BlockWorker/USBPD-Supply/LLCTrace.png

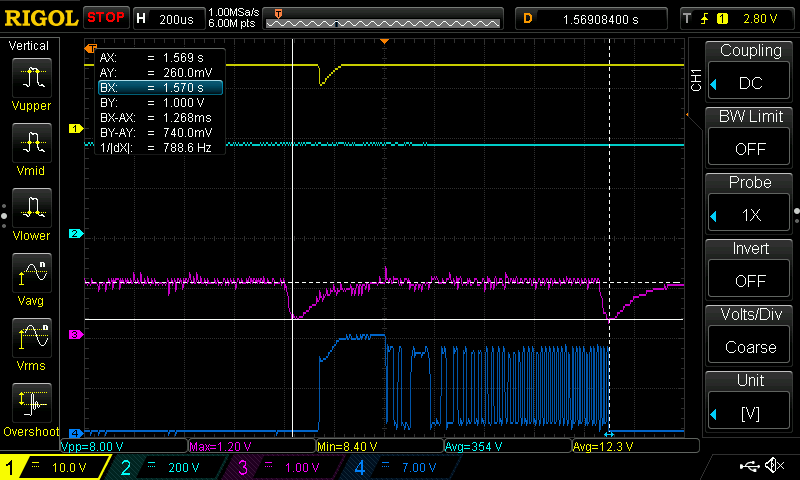
LLCTrace.png
