BlockWorker/USBPD-Supply/SchematicLLC.png

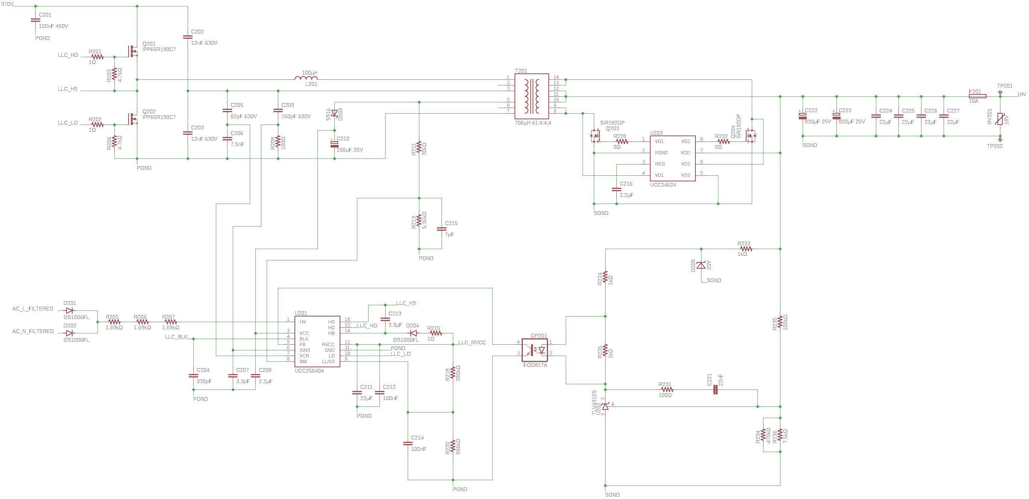
SchematicLLC.png
