BlockWorker/USBPD-Supply/SchematicPFC.png

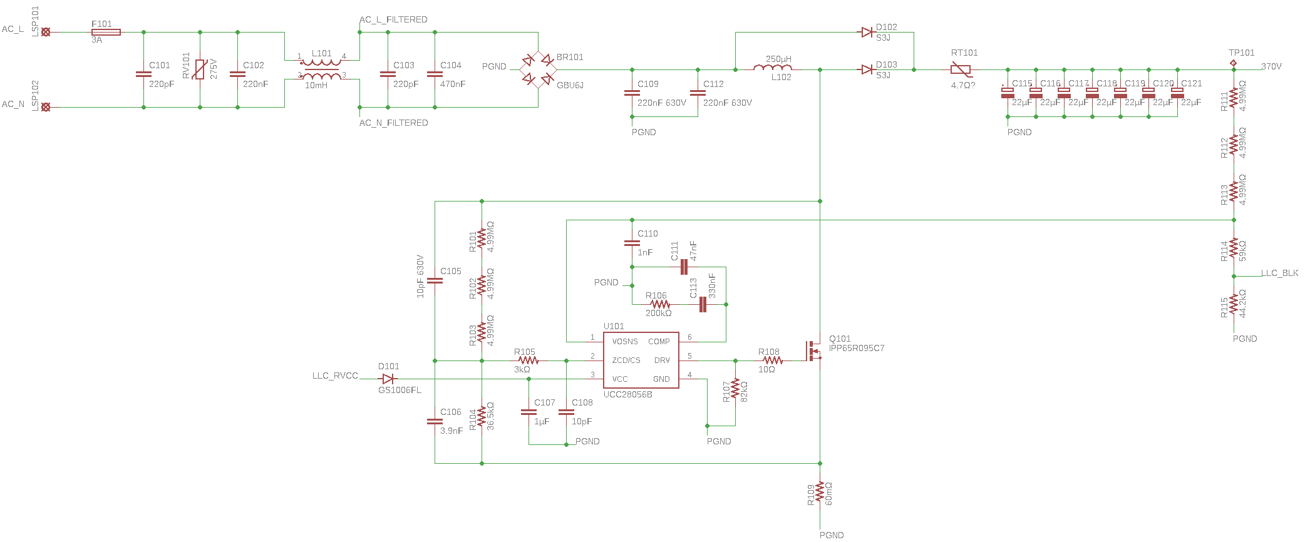
SchematicPFC.png
