BlockWorker/USBPD-Supply/TransistorFail_Event.png

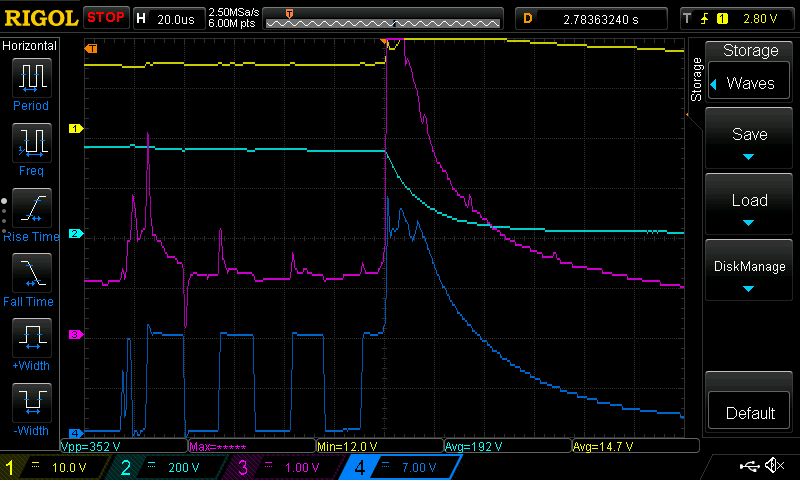
TransistorFail_Event.png
