BlockWorker/USBPD-Supply/TransistorFail_Full.png

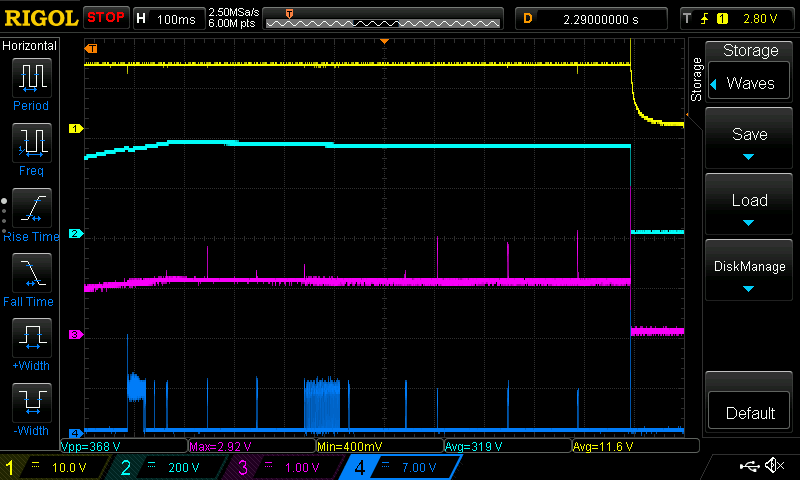
TransistorFail_Full.png
