BlockWorker/USBPD-Supply/UCC25640x Design Calculator Rev4.0.xlsx

Sheet: SCHEMATIC
RefDes | Value | Unit
RBLKupper | 14.97 | MΩ
RBLKlower | 44.2 | kΩ
RBWupper | 30.00 | KΩ
RBWlower | 5.36 | KΩ
CISNS | 150 | pF
RISNS | 100 | Ω
CVCRupper | 82 | pF
CVCRlower | 7500 | pF
Lr | 108.81 | uH
Lm | 706 | uH
Cr | 0.024 | uF
CSS | 1000 | nF
RLLupper | 390.00 | KΩ
RLLlower | 866.00 | KΩ

Sheet: Transformer Models
Power stage Gain Calcuation for discrete Lr
Power Stage Gain Calculation for Integrated Leakge

Sheet: DESIGN INPUTS AND CALCULATIONS
UCC25640x DESIGN CALCULATOR TOOL
TI Literature Number: | Version: Original
UCC25640x Enhanced LLC Resonant Controller
Please enter design parameters into the | shaded | cells;
Recommended Component Values will be in RED
Be sure to ENABLE EDITING before attempting to use this design calculator
This spreadsheet guides the user through the design process of an LLC resonant DC/DC CONVERTER using the UCC25640x. User interaction is required in order to get the best possible results. Enter the desired specification where prompted, the highlighted cells are for user inputs; calculations for the design are based upon the inputs.
WHERE APPLICABLE, A RECOMMENDED VALUE IS GIVEN THAT WILL BE THE BEST CHOICE TO MEET THE GIVEN SPECIFICATION. IT IS IN THE BEST INTEREST OF THE USER TO USE A VALUE AS CLOSE AS POSSIBLE TO THE SUGGESTED RECOMMENDED VALUE. FOR ACCURATE RESULTS, THE USER MUST ENTER THE ACTUAL VALUE USED IN THE APPROPRIATE CELL.
Disclaimer
This product is designed as an aid for customers of Texas Instruments. No warranties, either expressed or implied, with respect to this software or its fitness for any particular purpose, are claimed by Texas Instruments or the author. The software is licensed solely on an "as is" basis. The entire risk as to its quality and performance is with the customer.
Select Which Device You Are Using |  | UCC256404 |  | Refer datasheet for the difference of UCC25640x devices
OUTPUT
Output Voltage | VOUT | 18 | V | Enter required nominal output voltage of converter
Maximum Output Power | POUT | 144 | W | Enter required maximum converter output power in Watts
Full Load Output Current | IOUT | 8 | A
Maximum Output Voltage Ripple | VOUT(pk-pk) | 120 | mV | Enter the desired maximum output voltage ripple
Target Efficiency | h | 0.98 |  | Enter the Overall Efficiency here
INPUT
Nominal Input Voltage | VBLK | 370 | V | Enter the nominal input voltage
Maximum DC Input Voltage | VBLK(max) | 400 | V | Enter the maximum input voltage
Minimum DC Input Voltage | VBLK(hu) | 340 | V | Enter the minimum input voltage
LLC STAGE
Nominal LLC Switching Frequency | fLLC | 100 | kHz | Enter desired nominal LLC switching frequency
LLC Transformer
Recommended Primary/Secondary Turns Ratio | NPS(recommended) | 10.27777778
Actual Primary/Secondary Turns Ratio | NPS | 10.25 |  | Enter Actual Primary/Secondary Turns Ratio
Recommended Primary/Bias Turns Ratio | NPB(recommended) | 12.33
Actual Primary/Bias Turns Ratio | NPB | 10.25 |  | Enter Actual Primary/Bias Turns Ratio
LLC Effective Load Resistance at 110% Full Load | RE | 174.2 | Ω
LLC Effective Load Resistance at Full Load | RE(full load) | 191.6 | Ω
LLC Gain Range
Minimum LLC Gain | MG(min) | 0.948
Maximum LLC Gain Including Losses | MG(max) | 1.115
Predicted Voltage Drop Due to Losses | VLOSS | 0.000 | V | Enter the predicted voltage drop due to conversion losses in circuit
Select LN and QE
From the figure on the right, MG(peak) Vs QE with respect to LN, select a point on an Ln curve that has an Ln and QE point that corresponds to an Attainable MG(PEAK) value that is greater than MG(max). Enter the selected values in the LN and QE cells below.
For example, if MG(max), calculated above and shown by the horizontal line, was calculated to be 1.4, then using Ln = 5 and QE = 0.35 would result in an attainable MG(PEAK) = 1.52 (interpolated from Ln = 5 curve) which satisfies the requirement that the Attainable MG(PEAK) > MG(max)
Selected Primary Inductance Ratio | LN(selected) | 6.49
Selected Quality Factor for Resonant Network | QE(selected) | 0.35
Gain Required at No-Load | MG(noload) | 0.866
fN at Maximum Switching Frequency | fN(max) | 3.50
The selected LN and QE values should result in an LLC Gain Curve, shown below, that intersects with the MG(min) and MG(max) traces. The Gain curve from an overload condition is also plotted, showing the minimum gain at maximum frequency.
Parameters of the LLC Resonant Circuit
Discrete resonant inductor or transformer leakage inductance used for LR? |  | Discrete Inductor
 |  | 0.9 |  | Ignore this row
Recommended Resonant Capacitor Value | CR(recommended) | 0.024 | uF
Actual Total Value of Resonant Capacitor Used | CR | 0.024 | uF | Enter actual value of Resonant Capacitor used
Recommended Resonant Inductor Value | LR(recommended) | 105.543 | uH
Actual Resonant Inductor Value Used | LR | 108.81 | uH | Enter the actual value of the Resonant Inductor Value used
Recommended Transformer Magnetizing Inductance | LM(recommended) | 706.1769 | uH
Actual Transformer Magnetizing Inductance Used | LM | 706 | uH | Enter the actual value of the magnetizing inductance value used
Resultant Series Resonant Frequency | f0 | 98.5 | kHz
No Load Resonant Frequency | fP | 36.0 | kHz
Resultant Inductance Ratio | LN | 6.49 |  | Re-enter this value in the LN(selected) cell above to see the actual normalized frequency at MG(max) and MG(min)
Resultant Quality Factor at Full Load | QE | 0.35 |  | Re-enter this value in the QE(selected) cell above to see the actual normalized frequency at MG(max) and MG(min)
Gain Curve Graph Up to Date? |  | Yes
fN at MG(max) | fN(Mg_max) | 0.75 |  | Enter fN value at the second intersection of the MG(max) line and LLC Gain Curve shown in figure above
fN at MG(min) | fN(Mg_min) | 1.2 |  | Enter fN value at the second intersection of the MG(min) line and LLC Gain Curve shown in figure above
Maximum Switching Frequency | fSW(max) | 118.2 | kHz
Minimum Switching Frequency | fSW(min) | 73.9 | kHz
LLC Primary Side Currents
Primary Side RMS Load Current | IOE | 0.954 | A
RMS Magnetizing Current at fSW(min) | IM | 0.507 | A
Total Current in Resonant Circuit | IR | 1.080 | A
LLC Secondary Side Currents
Secondary RMS Current | IOE(S) | 9.774 | A
Current in Each Center Tapped Winding | IWS | 6.912 | A
LLC Resonant Inductor
Terminal AC Voltage Across Resonant Inductor | VLr | 54.538 | V
Inductance | LR | 108.810 | uH
Rated Current | IR | 1.080 | A
LLC Resonant Capacitor
AC Voltage Across Resonant Capacitor | VCR | 97.0 | V
RMS Voltage Across Resonant Capacitor | VCR(rms) | 222.3 | V
Peak Voltage AC Voltage Rating for Resonant Capacitor | VCR(peak) | 337.1 | V
Valley Voltage on Resonant Capacitor | VCr(valley) | 62.9 | V
Rated Current of Resonant Capacitor | IR | 1.080 | A
If Using Split Resonant Capacitors
Value of EACH Resonant Capacitor If Using Split Resonant Capacitors | CR(split) | 0.012 | uF
LLC Primary Side MOSFETs
Minimum Voltage Rating of LLC MOSFETs | VQLLC(peak) | 600.0 | V
RMS Current Rating of LLC MOSFETs | IQLLC | 1.188 | A
LLC Output Rectifier Diodes/Synchronous rectifiers
Minimum Voltage Rating for LLC Output Diodes | VDB | 46.829 | V
Minimum Current Rating for LLC Output Diodes | ISAV | 4.400 | A
LLC Output Capacitors, COUT
Rectifier's full wave output current | IRECT | 8.886 | A
COUT Minimum Voltage Rating | VLLCcap | 20 | V
COUT RMS Ripple Current Rating at resonant frequency | IC(out) | 3.867 | A | Use a combination of Capacitors that will meet this ripple current rating
COUT Maximum ESR | ESRmax | 9.549 | mΩ
BLK
BLK Pin Start Threshold | VBLKpinstart | 1.00 | V
BLK Pin Stop Threshold | VBLKpinstop | 0.90 | V
Desired Bulk Start Voltage | VBLKStart | 340 | V
Nominal Bulk Voltage | VBLK | 370 | V
Resistor Divider Ratio | kBLK | 340
Resistor Divider Power Consumption Budget | PBLKsns | 10 | mW | Enter the desired power consumption for resistor divider
Total BLK Sense Resistor Value | RBLKsns | 13.69 | MΩ
Recommended Lower BLK Sense Resistor Value | RBLKlower | 40.26 | kΩ
Actual Lower BLK Sense Resistor Value | RBLKlower | 44.2 | kΩ | Enter the actual value of the lower BLK sense resistor used
Recommended Upper BLK Sense Resistor Value | RBLKupper | 13.65 | MΩ
Actual Upper BLK Sense Resistor Value | RBLKupper | 14.97 | MΩ | Enter the actual value of the upper BLK sense resistor used
Actual Bulk Start Voltage | VBLKStart | 339.6877828 | V
Actual Bulk Stop Voltage | VBLKstop | 305.7190045 | V
Actual Bulk Over-Voltage Threshold Rising Threshold | VBLKOVPrise | Not Applicable | V | BLK OVP Feature only present in UCC256402A
Actual Bulk Over-Voltage Threshold Falling Threshold | VBLKOVfall | Not Applicable | V | BLK OVP Feature only present in UCC256402A
Actual BLK divider power consumption | PBLKsns | 9.118 | mW
VCR
Peak Resonant Current at Full Load | Ires(peak) | 1.53 | A
Peak to Peak Resonant Capacitor Voltage at Full Load | VCR(pk-pk) | 274.237 | V
Common Mode Voltage of VCR Pin | VCM | 3.02 | V
Set VCR pin voltage peak to peak at full load, minimum switching frequency | VVCRpin(pk-pk) | 5.25 | V | Suggested range between 3V and 5.5V
Set Contribution of compensation ramp to total VCR capacitor peak to peak voltage | Vramp(pk-pk) | 2 | V | Suggested range between 1V and 2.0V
Compensation Ramp Current Source Value | IRamp | 2 | mA
Required capacitor divider ratio | kCapDiv | 84.38
Recommended Capacitor Divider Value - Lower Cap | CVCRlower | 6769.064234 | pF
Actual Capacitor Divider Value - Lower Cap | CVCRlower | 7500.0 | pF | Enter the Capacitor divider value - lower cap
Recommended Capacitor Divider Value - Upper Cap | CVCRupper | 89.94912205 | pF
Actual Capacitor Divider Value - Upper Cap | CVCRupper | 82.0 | pF | Enter the Capacitor divider value - upper cap
Actual capacitor divider ratio | kCapDiv | 92.5
Actual peak to peak VCR voltage at minimum switching frequency | VVCRpin(pk-pk) | 4.77 | V
Maximum VCR Voltage | VVCRmax | 5.41 | V
Minimum VCR Voltage | VVCRmin | 0.63 | V
BW
Desired OVP Threshold Percentage of Nominal Vout | ƞOVP | 140 | % | Enter the OVP threshold (percentage)
OVP Threshold Adjustment to Account for Rectifying Element, Transformer Leakage, Resistive Losses In Power Stage, etc. | VDrop | 1 | V | Enter estimation for voltage drop within power stage (rectifying element, resistive losses, transformer leakage, etc).
OVP Threshold | VBWOVP | -4 | V
BW Pin Voltage at Nominal Vout | VBWpinNom | -2.86 | V
Bias Winding Nominal Voltage | VBiasWindingNom | 19.0 | V
Bias Winding Resistor Divider Ratio | kBW | 6.650
Select Option for Burst Mode Threshold Entry to Burst Mode Threshold Exit Ratio | kBMT | Option 6 |  | Select Ratio between burst mode entry and burst exit, Note Option 5 forces Vssinit to be 0 V while option 6 allows programming an initial Vssinit voltage value
Ratio Between Burst Mode Entry and Burst Mode Exit | kBMT | 0.6
Recommended Effective BW Programming Resistance | RBMTProgram | 4.591 | KΩ
Recommended Bias Winding Lower Resistor Value | RBWlower | 5.404 | KΩ
Actual Bias Winding Lower Resistor Value | RBWlower | 5.360 | KΩ | Enter Bias winding lower resistor value
Recommended Bias Winding Upper Resistor Value | RBWupper | 30.284 | KΩ
Actual Bias Winding Upper Resistor Value | RBWupper | 30.000 | KΩ | Enter Bias winding upper resistor value
Actual BW Programming Resistance | RBMTProgram | 4.548 | KΩ
Actual Option for Ratio Between Burst Mode Entry and Burst Mode Exit | kBMT | Option 6
Actual Ratio Between Burst Mode Entry and Burst Mode Exit | kBMT | 0.60
Actual OVP Threshold Percentage of Nominal Vout | ƞOVP | 138.9 | %
BW Filter Capacitor Needed so That the Bandwidth is 50 Times the Resonant Frequency |  | 7.11 | pF
Actual BW Filter Capacitor |  | 7.00 | pF | Enter the actual BW filter capacitor value
LL/SS
SS Current Source Value | ISSUp | 37.5 | µA
Required Soft Start Time at Full Load | TSS | 15 | ms | Enter the required soft start time at full load
Recommended SS Capacitance Value | CSS | 111.2489721 | nF
Actual SS Capacitance Value | CSS | 1000 | nF | Enter the selected soft start capacitance
Target Burst Mode Threshold Exit Setting | VBMT_H | 2.00 | V | Enter the desired burst mode threshold.
Minimum Soft Start Precharge Voltage Based on VBMT_H and Css | Vssinit_min | 0.055 | V
Desired initial Soft Start Precharge Voltage | Vssinit | 0.07 | V | Enter the desired initial soft start voltage. Note Vssinit must satisfy the inequality above unless BW Option 5 is selected. This calculation is provded in Cell 202. It is recommended to limit the precharge voltage to less than 1V.
Recommended Upper LL/SS Resistance | RLL/SS_Upper | 383.4 | kΩ
Recommended Lower LL/SS Resistance | RLL/SS_Lower | 800.9 | kΩ
Actual Upper LL/SS Resistance | RLL/SS_Upper | 390.0 | kΩ | Enter the LL/SS divider value upper resistance
Actual Lower LL/SS Resistance | RLL/SS_Lower | 866.0 | kΩ | Enter the LL/SS divider value lower resistance
Actual initial Soft Start Precharge Voltage | Vssinit | 0.066 | V
Maximum attainable LL/SS Voltage at End of Soft Start | Vssinit_final | 19.047 | V | Recommended to have >5V for max attainable LL/SS voltage
Actual Burst Mode Exit Threshold | VBMT_H | 2.032 | V
Actual Burst Mode Entry Threshold | VBMT_L | 1.219 | V
Burst Packet Size | NBurst | 40 |  | Minimum number of switching cycles in each burst packet
Actual Soft Start Time at Full Load | TSS | 125.5 | ms
ISNS
OCP3 Threshold |  | 0.43 | V
OCP2 Threshold |  | 0.6 | V
OCP1 Threshold |  | 4 | V
Desired OCP3 Threshold (Percentage of Full Load at Nominal Input Voltage) |  | 130 | % | Enter the desired OCP threshold (percentage)
Calculated OCP2 Level (Percentage of Full Load at Nominal Input Voltage) |  | 181.4 | %
Sensed Average Input Current Level at Full Load |  | 0.33 | V
Current Sense Ratio | kISNS | 0.83
Select a Current Sense Capacitor | CISNS | 150 | pF | Enter the current sense capacitor value such that the calculated RISNS < 500 Ω
Recommended Current Sense Resistor | RISNS | 133.2632479 | Ω
Actual Current Sense Resistor | RISNS | 100 | Ω | Enter the actual current sense resistor value
Peak VISNS at Full Load |  | 0.95 | V
Ires peak at OCP1 Level |  | 6.40 | A
Isec peak at OCP1 Level |  | 65.60 | A

Sheet: Comepsation and Transient
 | UCC25640X LLC Loop Plot & Load Transient Validation & Tuning Tool
LLC Power Stage Input |  |  |  | LLC Controller Parameter Setting |  |  |  | UCC25640X Loop Circuit setting
PFC input | Vin | 370 | VDC | VCR divider Capacitor_Higher Cap | CdivH | 82 | pF | Equivalent Controller Internal Resistor | RFB | 50 | kΩ
Output Rectifier forward Voltage | Vf | 0 | VDC | VCR divider Capacitor_Lower Cap | CdivL | 7.5 | nF | Feedback Pull up Resistor | Rf | 2 | kΩ
Set output Voltage | Vo_set | 18 | VDC | Calculated Parralled value | Cdivp | 81.11316275 | pF | OPTO Current Transfer Ratio | CTR | 0.8
Output Load current under R Load | Io | 8 | A | Calcualted Series Value | Cdivs | 7.582 | nF | OPTO Rolling off Frequency | f_roll | 15 | kHz
output total Capacitor Value | Co | 1640 | uF | Calcualted divided Value | λ | 0.01081508837 |  | Resistor for f_roll compensation | Rz | 1000 | Ω
Equivalent ESR for Co | Rc | 20 | mΩ | MOS Junction Capacitor | Cj | 0.374 | nF | Calculate Cz for f_roll compensation | Cz_cal | 3.183098862 | nF
LLC Transformer Magnetizing Inductance | Lm | 706 | uH | Output Load Transient Setting |  |  |  | Capacitor for f_roll compensation | Cz | 3.3 | nF
LLC Transformer Resonant Inductance | Ls | 108.81 | uH | Load step current | I_step | 7 | A | Rv compensation | Rv | 0.1 | kΩ
LLC Resonant Capacitor | Cr | 24 | nF | Load current step Duty cycle | Dstep | 0.5 |  | Cv compensation | Cv | 22 | nF
Equivalent Transformer Turn Ratio(Np:Ns) | N | 10.25 |  | Load step Frequency | fload | 0.2 | KHz | Cf compensation | Cf | 100 | pF
Actual Operation Frequency(Measured) | Fs | 100 | kHz | Load step slew rate | kslew | 20 | A/us | High side feedack resistor | Rupper | 100 | kΩ
Output R_Load | Rload | 2.25 | Ω | Load step Rising time | tr | 3.5e-07 | s | Feedack Circuit Design Option
Eqivalent LLC output | Vo | 18 | VDC | Load step on time | th | 0.0025007 | s | Use capacitor Cf?("Yes" for 1 and "No" for 0) |  | α_Cf | 0
Resonant Frequency | Fo | 98.48727144 | kHz | Load step Period | tload | 0.005 | s | Use Rz and Cz?("Yes" for 1 and "No" for 0) |  | α_Rz_Cz | 0
PFC Input AC Ripple(pk-pk) | Vinac | 10 | VAC | Center Step Load current | Istep_avg | 4 | A | Connect Rf to Vout?("Yes" for 1 and "No" for 0) |  | feedtype | 1
PFC Input AC Frequency | Fline | 50 | HZ
Crossover Frequency |  | #N/A | kHz
Phase Margin |  | #N/A | °
Calculation Result

Sheet: App Notes and Reference Designs
Application Notes
How to reduce audible noise and power consumption at standby in your AC/DC design (https://e2e.ti.com/blogs_/b/powerhouse/archive/2020/04/22/how-to-reduce-audible-noise-and-power-consumption-at-standby-in-your-ac-dc-design)
Migrating to UCC25640x from UCC25630x (Rev. A) (https://www.ti.com/lit/pdf/slua966)
Improving Transient Response in LLC Converters Using Hybrid Hysteretic Control (Rev. A) (https://www.ti.com/lit/pdf/slua834)
EVMs
AC to isolated DC EVM with UCC28056B, UCC256404 and UCC24624 (https://www.ti.com/tool/PFCLLCSREVM034)
UCC25640x half bridge LLC evaluation module (https://www.ti.com/tool/UCC25640EVM-020)
Reference Designs
180-W universal input PFC + LLC TV power supply reference design (https://www.ti.com/tool/PMP40580)
93% Efficiency, 400-W AC/DC reference design for avionics (https://www.ti.com/tool/PMP30763)
336-W Auxless AC/DC power supply reference design with 80 PLUS platinum compatible performance (https://www.ti.com/tool/PMP22087)
LLC Resonant converter control card reference design (https://www.ti.com/tool/PMP22088)
Universal input, 500-W CC/CV e-Bike charger reference design (https://www.ti.com/tool/PMP40766)
Single-stage AC/DC LCC resonant converter reference design (https://www.ti.com/tool/PMP22083)
>95% Efficiency, 1-kW analog control AC/DC reference design for 5G telecom rectifier (https://www.ti.com/tool/TIDA-010081)
Simplis Simulation Model
UCC25640x Simplis Model (https://www.ti.com/lit/zip/slum684)
