BlockWorker/USBPD-Supply/UCC28056X_Design Calculator.xls

Sheet: SCHEMATIC
Typical Schematic for a CRM/DCM Boost PFC Converter Using the UCC28056
 | RECOMMENDED BILL OF MATERIALS
 | Reference Designator | Description/Comments
 | FUSE | Type: | Fast Acting
 |  | Voltage Rating: | 250 | VRMS
 |  | Current Rating: | 3.00 | A
 | DB1 | DC Blocking Voltage: | 500 | V
 |  | Current Rating: | 3.00 | A
 |  | Power Dissipation: | 2.76 | W
 | CIN | Type: | Film Capacitor
 |  | Value: | 0.22 | µF
 |  | Volatge Rating: | 255 | VRMS
 | LBST | Inductor Value: | 250.00 | µH
 |  | Peak Current Rating: | 7.24 | µH
 |  | RMS Current: | 2.96 | A
 |  | Saturated Current: | 9.17 | A
 | D1 | Type: | Diode
 |  | Current Rating: | 3.00 | A
 |  | Volatge Rating: | 500 | V
 |  | Power Dissipation: | 0.48 | W
 | Q1 | Type: | MOSFET, Nchannel
 |  | RMS Drain Current Rating: | 2.00 | A
 |  | Peak Current Rating: | 1.60 | A
 |  | Voltage Rating: | 600 | V
 |  | Power Dissipation: | 1.00 | W
 | RCS | Type: | Resistor, Low Inductance
 |  | Value: | 0.06 | W
 |  | Power Dissipation: | 0.10 | W
 | RCS_FILTER | Type: | Resistor, Chip, 1/16W
 |  | Value: | 3000 | W
 | CCS_FILTER | Type: | Capacitor, Ceramic, 100V, X7R, ±10%
 |  | Value: | 10 | pF
 | RZC1 | Type: | Resistor, Low Inductance
 |  | Value: | 14.97 | MW
 |  | Power Dissipation: | 0.10 | 0
 | RZC2 | Type: | Resistor, Low Inductance
 |  | Value: | 36.5 | kW
 |  | Power Dissipation: | 0.10 | 0
 | COUT | Type: | Capacitor, Aluminum, ±20%
 |  | Value: | 150 | µF
 |  | Voltage Rating: | 500 | V
 |  | 2 x fLINE Ripple Current Rating: | 0.306 | ARMS
 |  | HF Ripple Current Rating: | 1.088 | ARMS
 | ROS1 | Type: | Resistor, Chip, Total Voltage Rating 400V, ±1%
 |  | Value: | 9 | MW
 | ROS2 | Type: | Resistor, Chip, 1/10W, ±1%
 |  | Value: | 0 | kW
 | ROS3 | Type: | Resistor, Chip, 1/10W, ±1%
 |  | Value: | 62 | kW
 | CVOSNS | Type: | Capacitor, Ceramic, 50V, X7R, ±10%
 |  | Value: | 1000 | pF
 | CZ | Type: | Capacitor, Ceramic, 10V, X5R, ±10%
 |  | Value: | 0.33 | mF
 | RZ | Type: | Resistor, Chip, 1/10W, ±1%
 |  | Value: | 200 | kW
 | CP | Type: | Capacitor, Ceramic, 10V, X5R, ±10%
 |  | Value: | 0.047 | mF
 | CVCC | Type: | Ceramic, Low ESR/ESL, placed close to the VCC and GND pins with short traces
 |  | Values: | 0.1 | mF min
 |  |  | 1 | mF max
 | RGATE | Type: | Resistor, Chip, 1/10W, ±1%
 |  | Value: | As Needed
 | RDG | Type: | Resistor, Chip, 1/10W, ±1%
 |  | Value: | As Needed

Sheet: DESIGN INPUTS AND CALCULATIONS
UCC28056X DESIGN CALCULATOR TOOL
TI Literature Number: |  | Rev A
UCC28056X 6-Pin Single-Phase Transition-Mode PFC Controller
Please enter design parameters into the | shaded | cells;
Calculated results will be in RED |  |  |  |  | COMP | 0.1 | 0.2 | 0.25 | 0.5 | 0.75 | 1
Be sure to ENABLE EDITING before attempting to use this design calculator |  |  |  |  | VFF_F | 90 | 104.96 | 122.4 | 142.74 | 166.46 | 194.12 | 226.38 | 264 | alpha | TONn(0.1) | TONn(0.2) | TONn(0.25) | TONn(0.5) | TONn(0.75) | TONn(1) | TDCHn(0.1) | TDCHn(0.2) | TDCHn(0.25) | TDCHn(0.5) | TDCHn(0.75) | TDCHn(1) | Freq(0.1)
This spreadsheet guides the user through the design process of a Transition-Mode PFC BOOST CONVERTER using the UCC28056X. User interaction is required in order to get the best possible results. Enter the desired specification where prompted, the highlighted cells are for user inputs; calculations for the design are based upon the inputs. |  |  |  |  | TDCMCoe | 0.15 | 0.45 | 0.16 | 0.52 |  |  |  |  | 0.01 | 0.3474399432 | 0.3335539928 | 0.3246635995 | 0.3676269822 | 0.5514404733 | 0.7352539643 | 0.001327962407 | 0.001274888428 | 0.001240908144 | 0.001405119997 | 0.002107679996 | 0.002810239995 | 47403.03457 | 102864.3291 | 135719.0137 | 211702.4496 | 141134.9664 | 105851.2248
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
