BlockWorker/USBPD-Supply/Adapter sketches/back.dxf

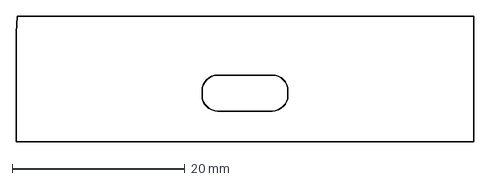
[picture p6: CAD file, 2023-05-07]
Adapter sketches/back.dxf
53.0 x 14.5 mm
