BlockWorker/USBPD-Supply/BottomCover.stl

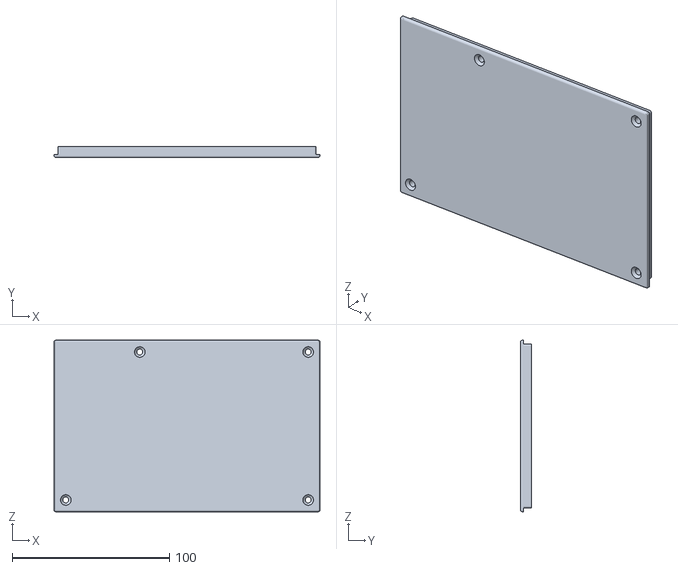
[picture p7: CAD file, 2024-01-15]
BottomCover.stl
169.0 x 7.00 x 109.0
