BlockWorker/USBPD-Supply/Adapter sketches/front.dxf

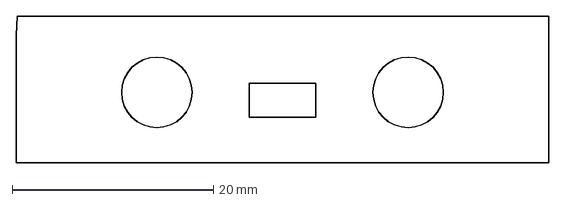
[picture p8: CAD file, 2023-05-07]
Adapter sketches/front.dxf
53.0 x 14.5 mm
