BlockWorker/USBPD-Supply/Adapter sketches/top.dxf

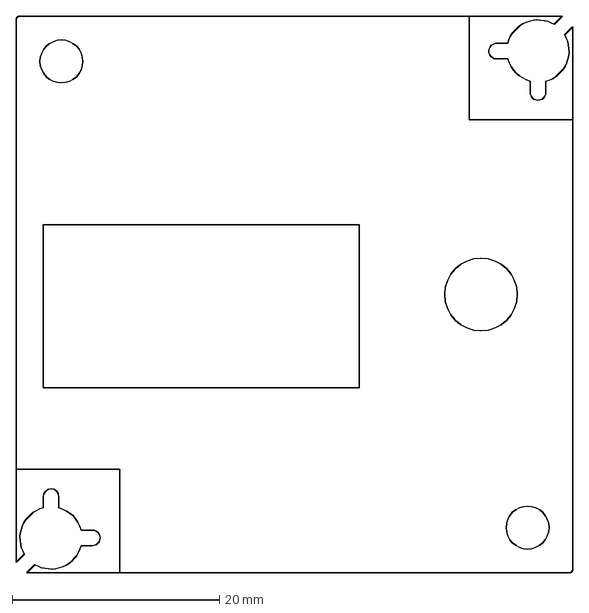
[picture p9: CAD file, 2023-05-07]
Adapter sketches/top.dxf
53.7 x 53.7 mm
