BlockWorker/USBPD-Supply/pfc/DS1Z_QuickPrint3.png

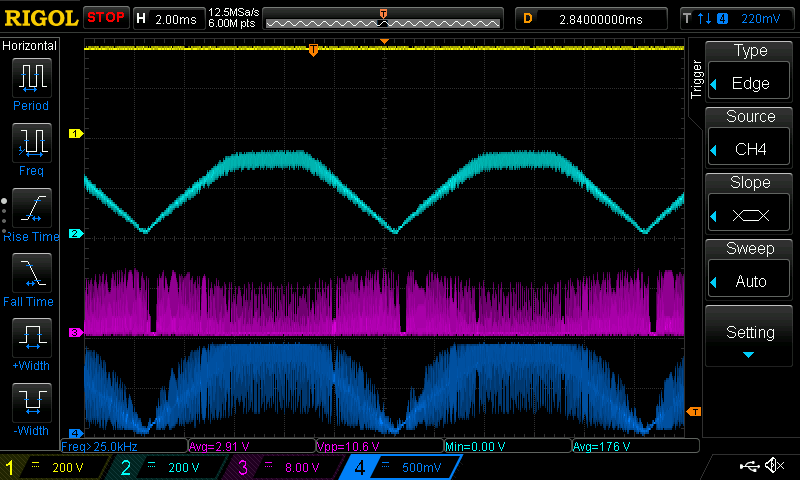
pfc/DS1Z_QuickPrint3.png
