BlockWorker/USBPD-Supply/pfc/DS1Z_QuickPrint4.png

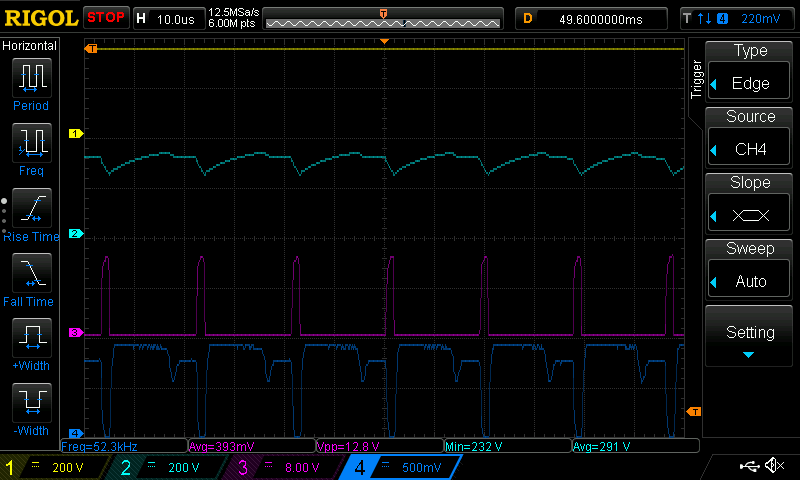
pfc/DS1Z_QuickPrint4.png
