BlockWorker/USBPD-Supply/pfc/DS1Z_QuickPrint5.png

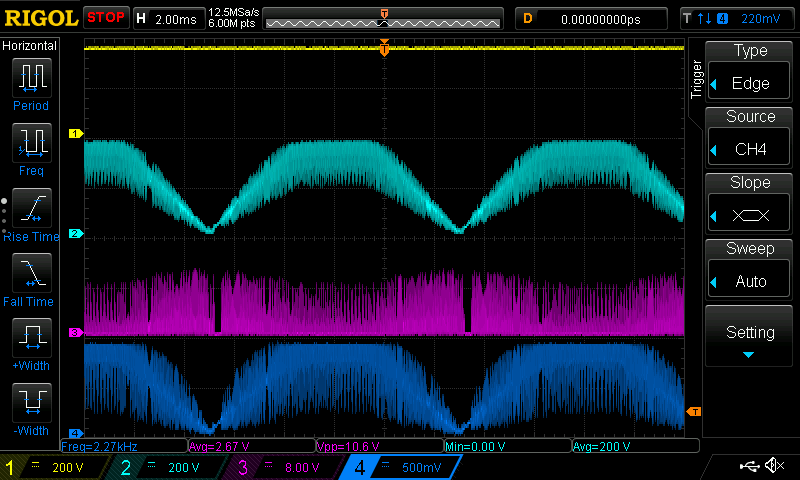
pfc/DS1Z_QuickPrint5.png
