BlockWorker/USBPD-Supply/pfc/DS1Z_QuickPrint6.png

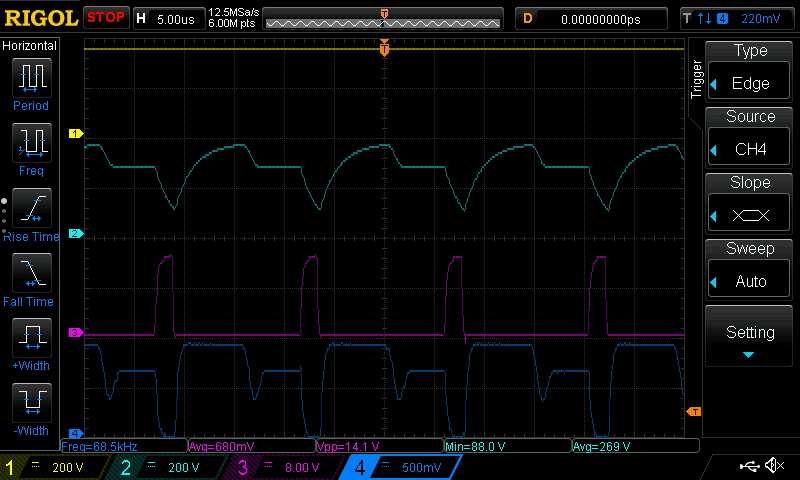
pfc/DS1Z_QuickPrint6.png
