BlockWorker/USBPD-Supply/pfc/DS1Z_QuickPrint7.png

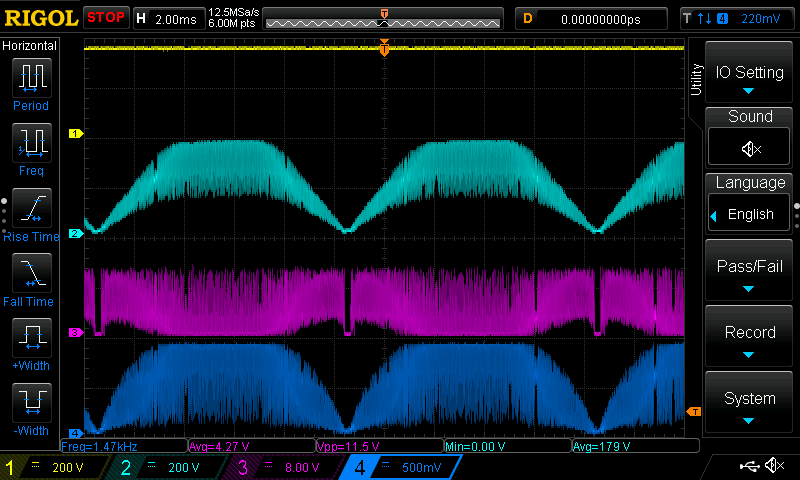
pfc/DS1Z_QuickPrint7.png
