BlockWorker/USBPD-Supply/pfc/DS1Z_QuickPrint8.png

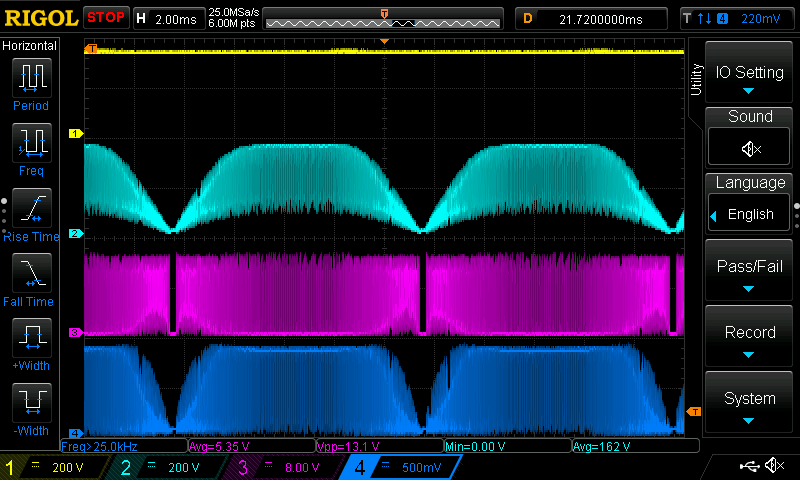
pfc/DS1Z_QuickPrint8.png
