BlockWorker/USBPD-Supply/pfc/DS1Z_QuickPrint9.png

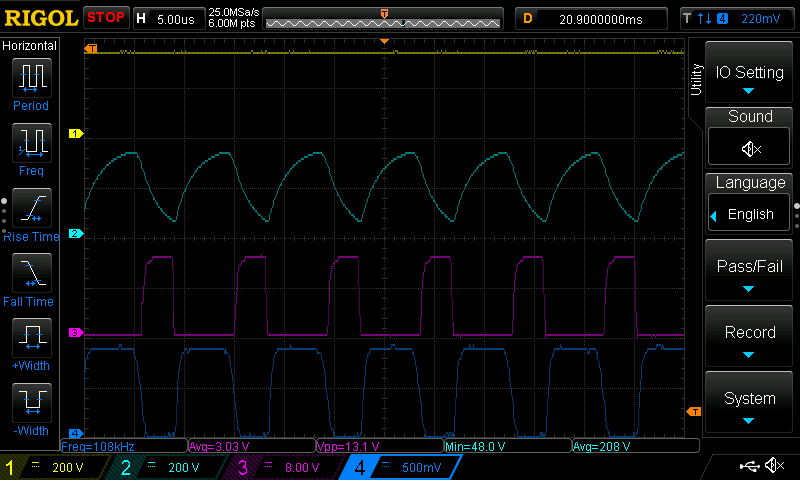
pfc/DS1Z_QuickPrint9.png
