BlockWorker/USBPD-Supply/pfc/DS1Z_QuickPrint10.png

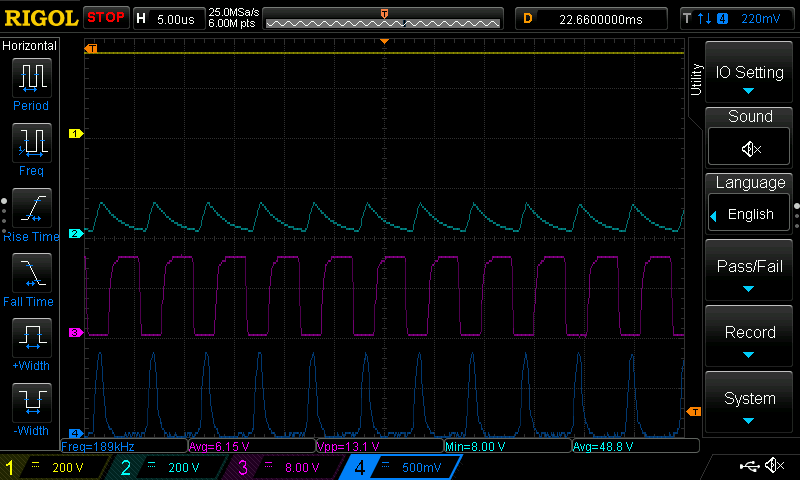
pfc/DS1Z_QuickPrint10.png
