BlockWorker/USBPD-Supply/pfc/DS1Z_QuickPrint11.png

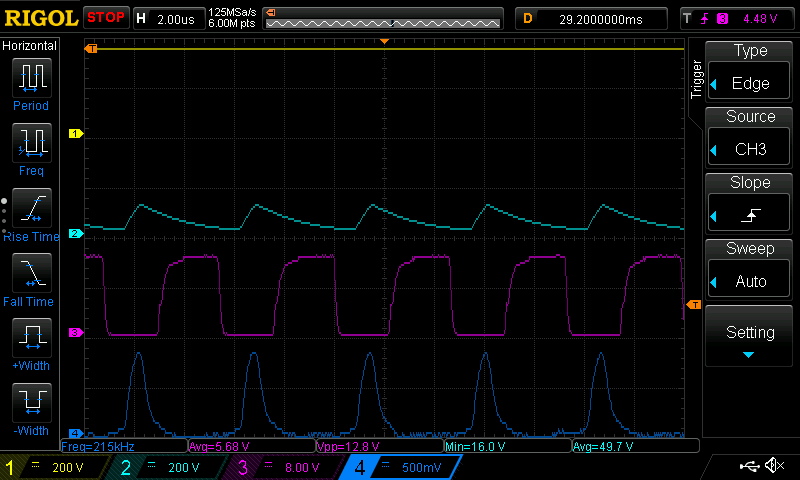
pfc/DS1Z_QuickPrint11.png
