BlockWorker/USBPD-Supply/pfc/DS1Z_QuickPrint12.png

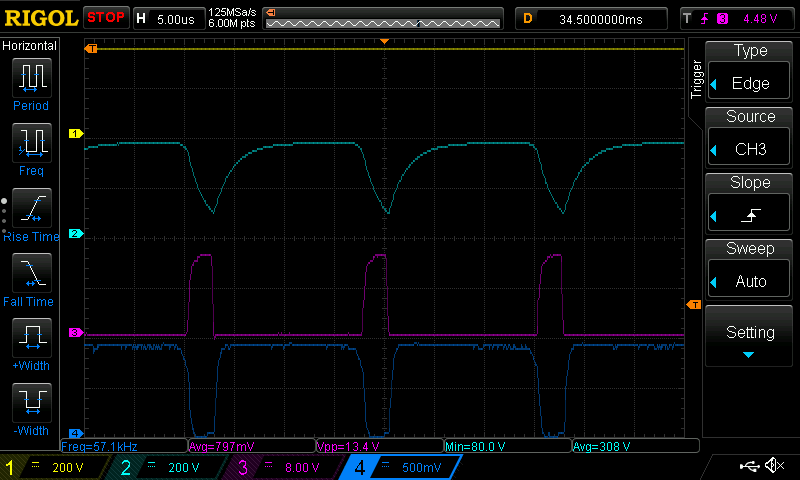
pfc/DS1Z_QuickPrint12.png
