BlockWorker/USBPD-Supply/TransformerTest1Trace.png

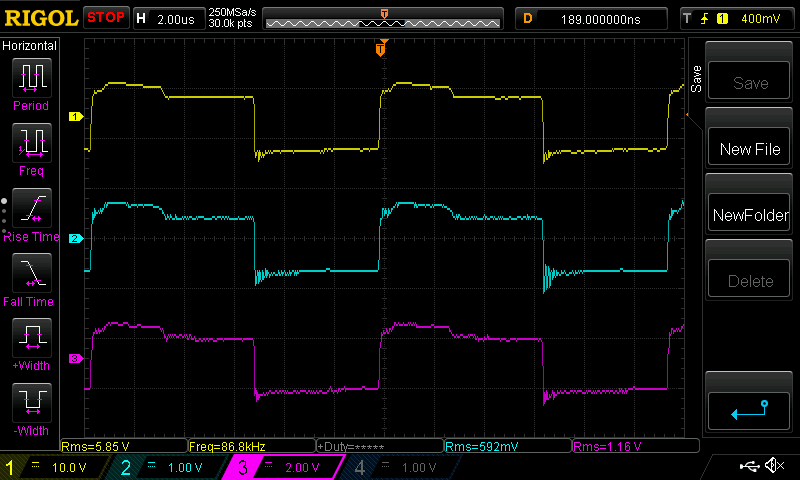
TransformerTest1Trace.png
