BlockWorker/USBPD-Supply/TransformerTest2Trace.png

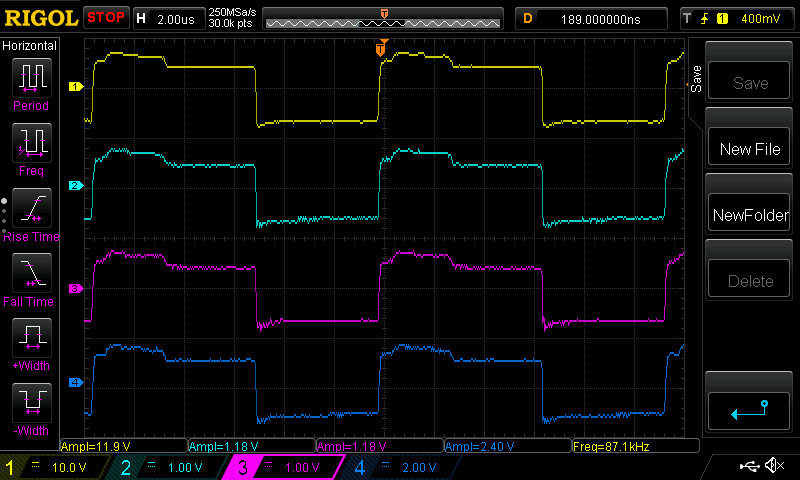
TransformerTest2Trace.png
