BlockWorker/USBPD-Supply/main.brd

## EAGLE design main.brd (2024-01-15)

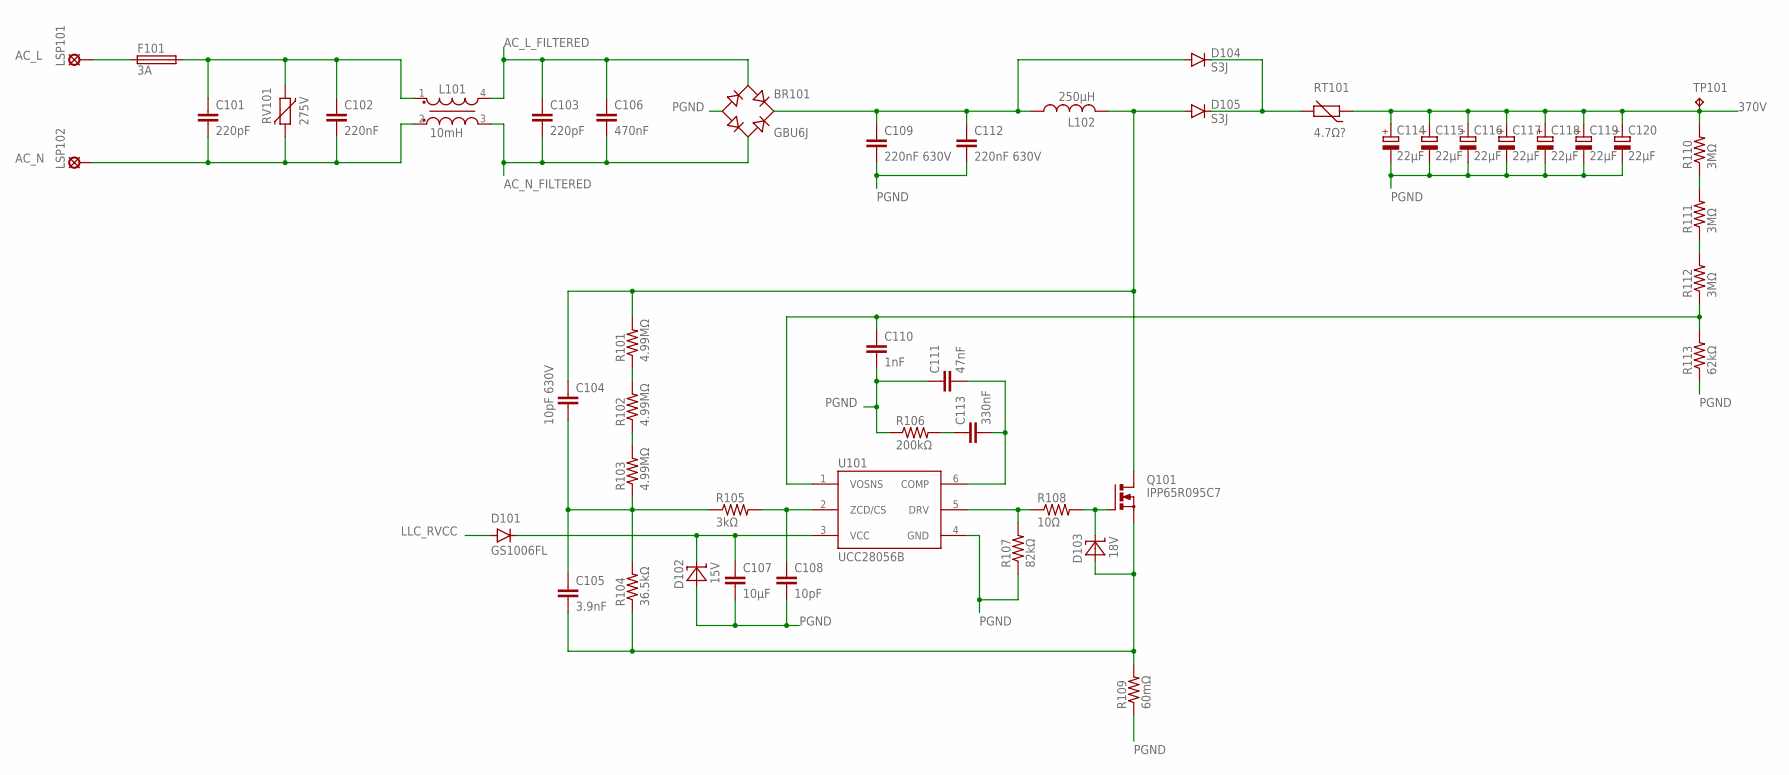
[picture p22: schematic main.sch, sheet 1, Mains PFC]

Parts:
BR101: GBU6J; GBU6
C101, C103: 220pF; C-10MM-TH
C102: 220nF; WCAP-FTX2-220N
C104: 10pF 630V; C1206
C105: 3.9nF; C0603
C106: 470nF; WCAP-FTX2-470N
C107: 10µF; C0805
C108: 10pF; C0603
C109, C112: 220nF 630V; C1812
C110: 1nF; C0603
C111: 47nF; C0603
C113: 330nF; C0603
C114, C115, C116, C117, C118, C119, C120: 22µF; E5-12.5
D101: GS1006FL; SOD123FL
D102: 15V; SOD123
D103: 18V; SOD123
D104, D105: S3J; SMC
F101: 3A; MRF_FUSE
L101: 10mH; WE-CMB_M
L102: 250µH; ATCA-08
LSP101: AC_L; LSP13
LSP102: AC_N; LSP13
Q101: IPP65R095C7; TO220BV-HS1
R101, R102, R103: 4.99MΩ; R1206
R104: 36.5kΩ; R0603
R105: 3kΩ; R0603
R106: 200kΩ; R0603
R107: 82kΩ; R0603
R108: 10Ω; R0603
R109: 60mΩ; R1206
R110, R111, R112: 3MΩ; R1206
R113: 62kΩ; R0603
RT101: 4.7Ω?; R-5
RV101: 275V; B72207S0271
TP101: RCU-0(J); TP_0603_JOINED
U101: UCC28056B; SOT23-6L

Connections:
370V: C114.+, C115.+, C116.+, C117.+, C118.+, C119.+, C120.+, R110.2, RT101.1, TP101.1; also elsewhere on the board
AC_L: F101.1, LSP101.MP
AC_L_FILTERED: BR101.2 (AC1), C103.1, C106.1, L101.4; also elsewhere on the board
AC_L_FUSED: C101.1, C102.1, F101.2, L101.1, RV101.1
AC_N: C101.2, C102.2, L101.2, LSP102.MP, RV101.2
AC_N_FILTERED: BR101.3 (AC2), C103.2, C106.2, L101.3; also elsewhere on the board
AC_RECTIFIED: BR101.4 (+), C109.1, C112.1, D104.A, L102.1
LLC_RVCC: D101.A; also elsewhere on the board
PFC_COMP: C111.2, C113.2, U101.6 (COMP)
PFC_COMP_INT: C113.1, R106.2
PFC_CS: C105.2, D103.A, Q101.S, R104.1, R109.2
PFC_DRV: R107.2, R108.1, U101.5 (DRV)
PFC_DRV_R: D103.C, Q101.G, R108.2
PFC_OUT_RAW: D104.C, D105.C, RT101.2
PFC_SW_NODE: C104.1, D105.A, L102.2, Q101.D, R101.2
PFC_VCC: C107.1, D101.C, D102.C, U101.3 (VCC)
PFC_VOSNS: C110.1, R112.1, R113.2, U101.1 (VOSNS)
PFC_VOSNS_RB: R111.1, R112.2
PFC_VOSNS_RT: R110.1, R111.2
PFC_ZCD/CS: C108.1, R105.2, U101.2 (ZCD/CS)
PFC_ZCD/CS_RAW: C104.2, C105.1, R103.1, R104.2, R105.1
PFC_ZCD_RB: R102.1, R103.2
PFC_ZCD_RT: R101.1, R102.2
PGND: BR101.1 (-), C107.2, C108.2, C109.2, C110.2, C111.1, C112.2, C114.-, C115.-, C116.-, C117.-, C118.-, C119.-, C120.-, D102.A, R106.1, R107.1, R109.1, R113.1, U101.4 (GND); also elsewhere on the board

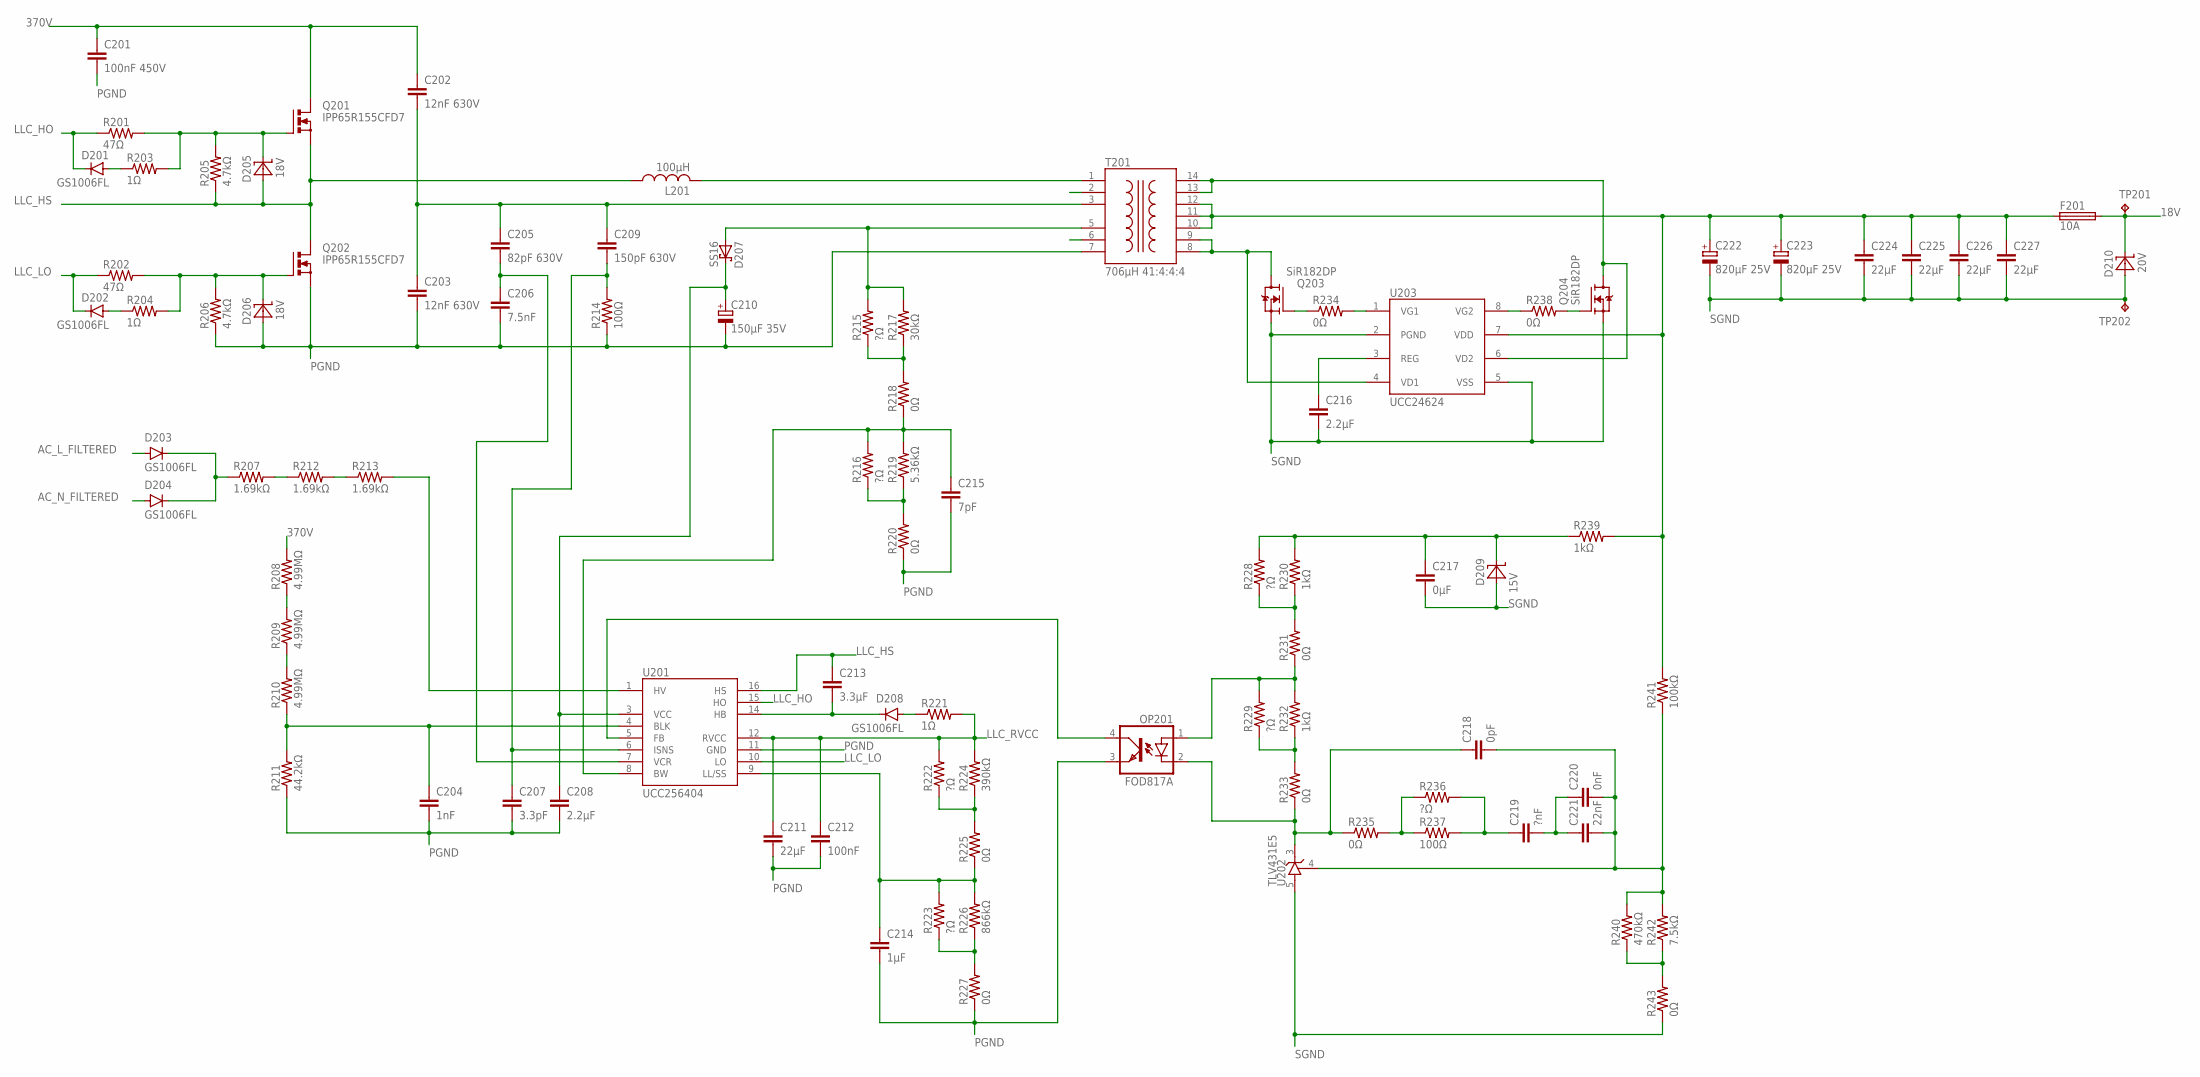
[picture p23: schematic main.sch, sheet 2, LLC]

Parts:
C201: 100nF 450V; C1206
C202, C203: 12nF 630V; C1210
C204: 1nF; C0603
C205: 82pF 630V; C1206
C206: 7.5nF; C0603
C207: 3.3pF; C0603
C208, C216: 2.2µF; C0805
C209: 150pF 630V; C1206
C210: 150µF 35V; PANASONIC_E
C211, C224, C225, C226, C227: 22µF; C0805
C212: 100nF; C0603
C213: 3.3µF; C0805
C214: 1µF; C0603
C215: 7pF; C0603
C217: 0µF; C0603
C218: 0pF; C0603
C219: ?nF; C0603
C220: 0nF; C0603
C221: 22nF; C0603
C222, C223: 820µF 25V; E5-10,5
D201, D202, D203, D204, D208: GS1006FL; SOD123FL
D205, D206: 18V; SOD123
D207: SS16; DO-214AC
D209: 15V; SOD123
D210: 20V; SOD123
F201: 10A; MRF_FUSE
L201: 100µH; HCTI-1MM
OP201: FOD817A; DIP4
Q201, Q202: IPP65R155CFD7; TO220BV-HS1
Q203, Q204: SiR182DP; POWERPAK-SO8
R201, R202: 47Ω; R0603
R203, R204, R221: 1Ω; R0603
R205, R206: 4.7kΩ; R0603
R207, R212, R213: 1.69kΩ; R1206
R208, R209, R210: 4.99MΩ; R1206
R211: 44.2kΩ; R0603
R214: 100Ω; R1206
R215, R216, R222, R223, R228, R229, R236: ?Ω; R0603
R217: 30kΩ; R0603
R218, R220, R225, R227, R231, R233, R234, R235, R238, R243: 0Ω; R0603
R219: 5.36kΩ; R0603
R224: 390kΩ; R0603
R226: 866kΩ; R0603
R230, R232, R239: 1kΩ; R0603
R237: 100Ω; R0603
R240: 470kΩ; R0603
R241: 100kΩ; R0603
R242: 7.5kΩ; R0603
T201: 706µH 41:4:4:4; ETD29/16/10-H
TP201, TP202: RCU-0(J); TP_0603_JOINED
U201: UCC256404; SOIC16-NO2,13
U202: TLV431E5; SOT23-5L
U203: UCC24624; SOIC8

Connections:
18V: D210.C, F201.2, TP201.1; also elsewhere on the board
370V: C201.1, C202.1, Q201.D, R208.2; also elsewhere on the board
AC_L_FILTERED: D203.A; also elsewhere on the board
AC_N_FILTERED: D204.A; also elsewhere on the board
LLC_AUX: D207.A, R215.2, R217.2, T201.5
LLC_BLK: C204.1, R210.1, R211.2, U201.4 (BLK)
LLC_BLK_RB: R209.1, R210.2
LLC_BLK_RT: R208.1, R209.2
LLC_BW: C215.1, R216.2, R218.1, R219.2, U201.8 (BW)
LLC_BW_RB: R216.1, R219.1, R220.2
LLC_BW_RT: R215.1, R217.1, R218.2
LLC_FB: OP201.4 (COL), U201.5 (FB)
LLC_FB_COMP: C219.1, R236.2, R237.2
LLC_FB_COMPC: C219.2, C220.1, C221.1
LLC_FB_COMPR: R235.2, R236.1, R237.1
LLC_FB_OPA: OP201.1 (A), R229.2, R231.1, R232.2
LLC_FB_OPAP: C217.1, D209.C, R228.2, R230.2, R239.1
LLC_FB_OPAR: R228.1, R230.1, R231.2
LLC_FB_OPBR: R229.1, R232.1, R233.2
LLC_FB_OPK: C218.1, OP201.2 (C), R233.1, R235.1, U202.3 (C)
LLC_FB_VREF: C218.2, C220.2, C221.2, R240.2, R241.1, R242.2, U202.4 (R)
LLC_FB_VREFR: R240.1, R242.1, R243.2
LLC_HB: C213.2, D208.C, U201.14 (HB)
LLC_HB_FEED: D208.A, R221.1
LLC_HO: D201.C, R201.1, U201.15 (HO)
LLC_HO_DIS: D201.A, R203.1
LLC_HO_R: D205.C, Q201.G, R201.2, R203.2, R205.2
LLC_HS: C213.1, D205.A, L201.1, Q201.S, Q202.D, R205.1, U201.16 (HS)
LLC_HV: R213.2, U201.1 (HV)
LLC_HV_RB: R212.2, R213.1
LLC_HV_RECT: D203.C, D204.C, R207.1
LLC_HV_RT: R207.2, R212.1
LLC_ISNS: C207.1, C209.2, R214.2, U201.6 (ISNS)
LLC_LL/SS: C214.1, R223.2, R225.1, R226.2, U201.9 (LL/SS)
LLC_LL_RB: R223.1, R226.1, R227.2
LLC_LL_RT: R222.1, R224.1, R225.2
LLC_LO: D202.C, R202.1, U201.10 (LO)
LLC_LO_DIS: D202.A, R204.1
LLC_LO_R: D206.C, Q202.G, R202.2, R204.2, R206.2
LLC_OUT: C222.+, C223.+, C224.1, C225.1, C226.1, C227.1, F201.1, R239.2, R241.2, T201.10, T201.11, T201.12, U203.7 (VDD)
LLC_PRI_IN: L201.2, T201.1
LLC_PRI_OUT: C202.2, C203.1, C205.1, C209.1, T201.3
LLC_RVCC: C211.1, C212.1, R221.2, R222.2, R224.2, U201.12 (RVCC); also elsewhere on the board
LLC_SR_REG: C216.1, U203.3 (REG)
LLC_SR_VD1: Q203.5-8 (D), T201.8, T201.9, U203.4 (VD1)
LLC_SR_VD2: Q204.5-8 (D), T201.13, T201.14, U203.6 (VD2)
LLC_SR_VG1: R234.2, U203.1 (VG1)
LLC_SR_VG1_R: Q203.4 (G), R234.1
LLC_SR_VG2: R238.1, U203.8 (VG2)
LLC_SR_VG2_R: Q204.4 (G), R238.2
LLC_VCC: C208.1, C210.+, D207.C, U201.3 (VCC)
LLC_VCR: C205.2, C206.1, U201.7 (VCR)
PGND: C201.2, C203.2, C204.2, C206.2, C207.2, C208.2, C210.-, C211.2, C212.2, C214.2, C215.2, D206.A, OP201.3 (EMIT), Q202.S, R206.1, R211.1, R214.1, R220.1, R227.1, T201.7, U201.11 (GND); also elsewhere on the board
PRI_DUMMY_1: T201.2
PRI_DUMMY_2: T201.6
SGND: C216.2, C217.2, C222.-, C223.-, C224.2, C225.2, C226.2, C227.2, D209.A, D210.A, Q203.1 (S), Q203.2 (S), Q203.3 (S), Q204.1 (S), Q204.2 (S), Q204.3 (S), R243.1, TP202.1, U202.5 (A), U203.2 (PGND), U203.5 (VSS); also elsewhere on the board

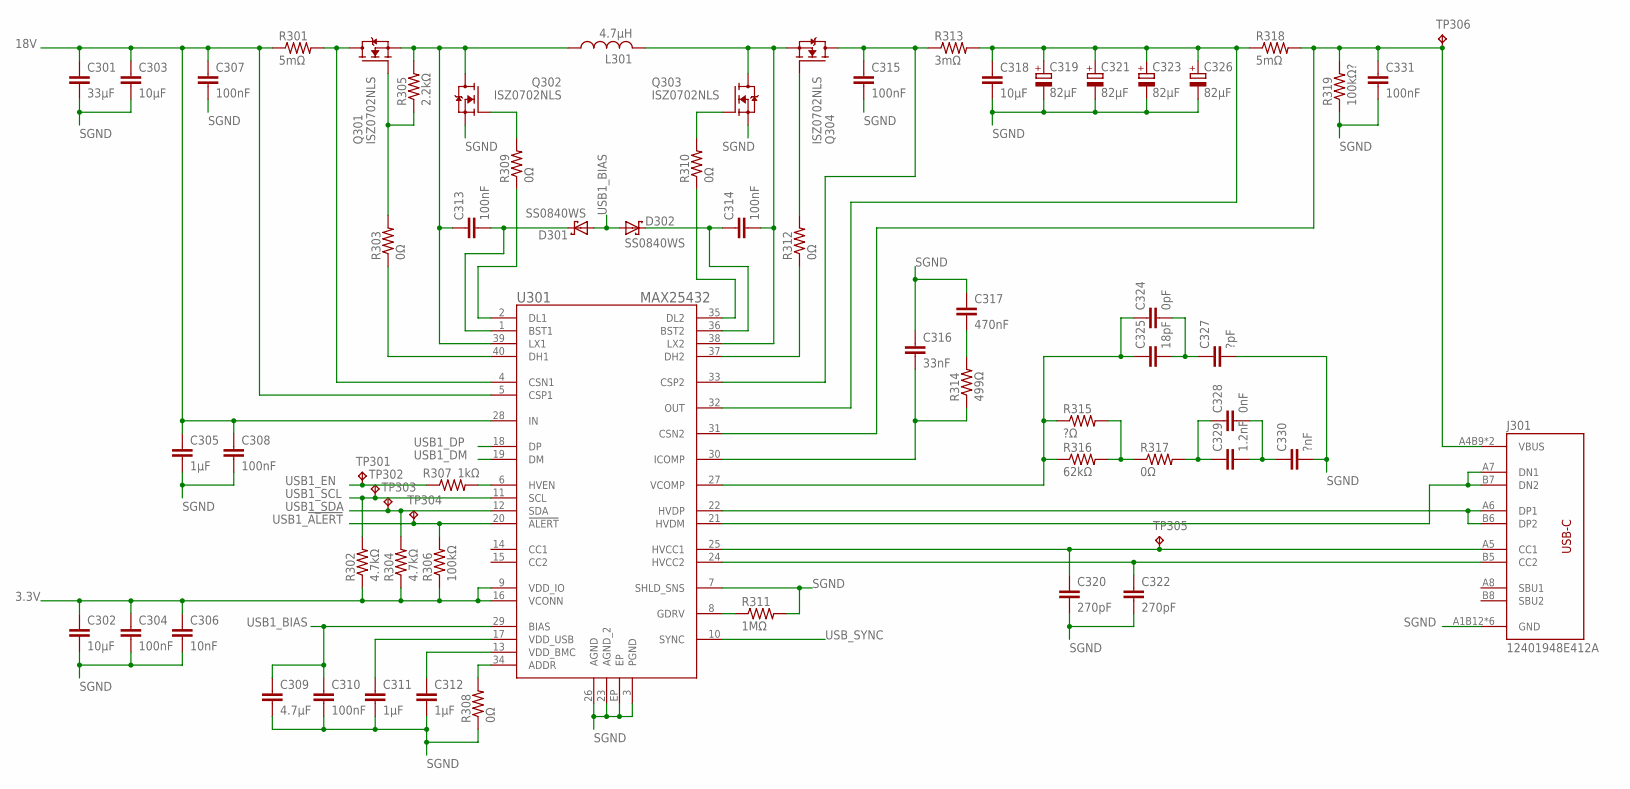
[picture p24: schematic main.sch, sheet 3, USB-C Port 1]

Parts:
C301: 33µF; C1206
C302, C303, C318: 10µF; C0805
C304, C307, C308, C310, C313, C314, C315, C331: 100nF; C0603
C305, C311, C312: 1µF; C0603
C306: 10nF; C0603
C309: 4.7µF; C0603
C316: 33nF; C0603
C317: 470nF; C0603
C319, C321, C323, C326: 82µF; E3,5-8
C320, C322: 270pF; C0603
C324: 0pF; C0603
C325: 18pF; C0603
C327: ?pF; C0603
C328: 0nF; C0603
C329: 1.2nF; C0603
C330: ?nF; C0603
D301, D302: SS0840WS; SOD323
J301: 12401948E412A
L301: 4.7µH; B82559B*A016
Q301, Q302, Q303, Q304: ISZ0702NLS; TSDSON-8
R301, R318: 5mΩ; R0805
R302, R304: 4.7kΩ; R0603
R303, R308, R309, R310, R312, R317: 0Ω; R0603
R305: 2.2kΩ; R0603
R306: 100kΩ; R0603
R307: 1kΩ; R0603
R311: 1MΩ; R0603
R313: 3mΩ; R0805
R314: 499Ω; R0603
R315: ?Ω; R0603
R316: 62kΩ; R0603
R319: 100kΩ?; R0603
TP301, TP302, TP303, TP304, TP305, TP306: RCU-0(J); TP_0603_JOINED
U301: MAX25432; TQFN-40

Connections:
3.3V: C302.1, C304.1, C306.1, R302.1, R304.1, R306.1, U301.9 (VDD_IO), U301.16 (VCONN); also elsewhere on the board
18V: C301.1, C303.1, C305.1, C307.1, C308.1, R301.1, U301.5 (CSP1), U301.28 (IN); also elsewhere on the board
SGND: C301.2, C302.2, C303.2, C304.2, C305.2, C306.2, C307.2, C308.2, C309.2, C310.2, C311.2, C312.2, C315.2, C316.1, C317.1, C318.2, C319.-, C320.2, C321.-, C322.2, C323.-, C326.-, C327.2, C330.2, C331.2, J301.A1B12 (GND), J301.B1A12 (GND), J301.M1 (GND), J301.M2 (GND), J301.M3 (GND), J301.M4 (GND), Q302.1 (S), Q302.2 (S), Q302.3 (S), Q303.1 (S), Q303.2 (S), Q303.3 (S), R308.1, R311.2, R319.1, U301.3 (PGND), U301.7 (SHLD_SNS), U301.23 (AGND_2), U301.26 (AGND), U301.EP; also elsewhere on the board
USB1_!ALERT: R306.2, TP304.1, U301.20 (!ALERT); also elsewhere on the board
USB1_ADDR: R308.2, U301.34 (ADDR)
USB1_BIAS: C309.1, C310.1, D301.2 (A), D302.2 (A), U301.29 (BIAS)
USB1_BST1: C313.2, D301.1 (C), U301.1 (BST1)
USB1_BST2: C314.1, D302.1 (C), U301.36 (BST2)
USB1_CC1: C320.1, J301.A5 (CC1), TP305.1, U301.25 (HVCC1)
USB1_CC2: C322.1, J301.B5 (CC2), U301.24 (HVCC2)
USB1_CSN1: Q301.5-8 (D), R301.2, U301.4 (CSN1)
USB1_CSP2: C315.1, Q304.5-8 (D), R313.1, U301.33 (CSP2)
USB1_DH1: R303.1, U301.40 (DH1)
USB1_DH1_R: Q301.4 (G), R303.2, R305.1
USB1_DH2: R312.1, U301.37 (DH2)
USB1_DH2_R: Q304.4 (G), R312.2
USB1_DL1: R309.1, U301.2 (DL1)
USB1_DL1_R: Q302.4 (G), R309.2
USB1_DL2: R310.1, U301.35 (DL2)
USB1_DL2_R: Q303.4 (G), R310.2
USB1_DM: U301.19 (DM); also elsewhere on the board
USB1_DP: U301.18 (DP); also elsewhere on the board
USB1_EN: R307.1, TP301.1; also elsewhere on the board
USB1_GDRV: R311.1, U301.8 (GDRV)
USB1_HVDM: J301.A7 (DN1), J301.B7 (DN2), U301.21 (HVDM)
USB1_HVDP: J301.A6 (DP1), J301.B6 (DP2), U301.22 (HVDP)
USB1_HVEN: R307.2, U301.6 (HVEN)
USB1_ICOMP: C316.2, R314.1, U301.30 (ICOMP)
USB1_ICOMP_R: C317.2, R314.2
USB1_LX1: C313.1, L301.1, Q301.1 (S), Q301.2 (S), Q301.3 (S), Q302.5-8 (D), R305.2, U301.39 (LX1)
USB1_LX2: C314.2, L301.2, Q303.5-8 (D), Q304.1 (S), Q304.2 (S), Q304.3 (S), U301.38 (LX2)
USB1_OUT: C318.1, C319.+, C321.+, C323.+, C326.+, R313.2, R318.1, U301.32 (OUT)
USB1_SCL: R302.2, TP302.1, U301.11 (SCL); also elsewhere on the board
USB1_SDA: R304.2, TP303.1, U301.12 (SDA); also elsewhere on the board
USB1_VBUS: C331.1, J301.A4B9 (VBUS), J301.B4A9 (VBUS), R318.2, R319.2, TP306.1, U301.31 (CSN2)
USB1_VCOMP: C324.1, C325.1, R315.1, R316.1, U301.27 (VCOMP)
USB1_VCOMP_CPI: C324.2, C325.2, C327.1
USB1_VCOMP_CZI: C328.2, C329.2, C330.1
USB1_VCOMP_R: C328.1, C329.1, R317.2
USB1_VCOMP_RI: R315.2, R316.2, R317.1
USB1_VDD_BMC: C312.1, U301.13 (VDD_BMC)
USB1_VDD_USB: C311.1, U301.17 (VDD_USB)
USB_SYNC: U301.10 (SYNC); also elsewhere on the board

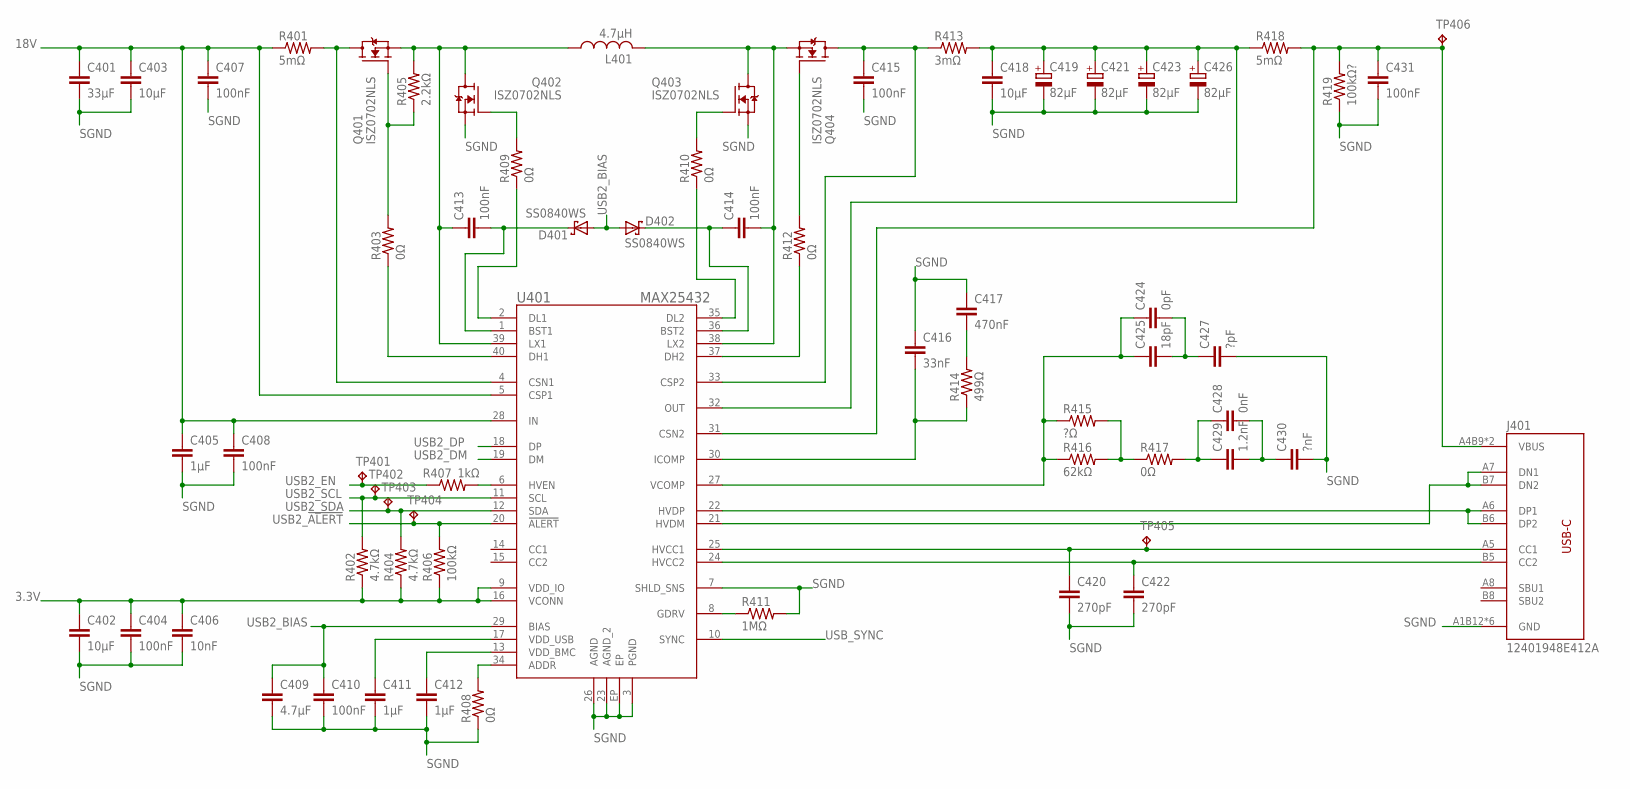
[picture p25: schematic main.sch, sheet 4, USB-C Port 2]

Parts:
C401: 33µF; C1206
C402, C403, C418: 10µF; C0805
C404, C407, C408, C410, C413, C414, C415, C431: 100nF; C0603
C405, C411, C412: 1µF; C0603
C406: 10nF; C0603
C409: 4.7µF; C0603
C416: 33nF; C0603
C417: 470nF; C0603
C419, C421, C423, C426: 82µF; E3,5-8
C420, C422: 270pF; C0603
C424: 0pF; C0603
C425: 18pF; C0603
C427: ?pF; C0603
C428: 0nF; C0603
C429: 1.2nF; C0603
C430: ?nF; C0603
D401, D402: SS0840WS; SOD323
J401: 12401948E412A
L401: 4.7µH; B82559B*A016
Q401, Q402, Q403, Q404: ISZ0702NLS; TSDSON-8
R401, R418: 5mΩ; R0805
R402, R404: 4.7kΩ; R0603
R403, R408, R409, R410, R412, R417: 0Ω; R0603
R405: 2.2kΩ; R0603
R406: 100kΩ; R0603
R407: 1kΩ; R0603
R411: 1MΩ; R0603
R413: 3mΩ; R0805
R414: 499Ω; R0603
R415: ?Ω; R0603
R416: 62kΩ; R0603
R419: 100kΩ?; R0603
TP401, TP402, TP403, TP404, TP405, TP406: RCU-0(J); TP_0603_JOINED
U401: MAX25432; TQFN-40

Connections:
3.3V: C402.1, C404.1, C406.1, R402.1, R404.1, R406.1, U401.9 (VDD_IO), U401.16 (VCONN); also elsewhere on the board
18V: C401.1, C403.1, C405.1, C407.1, C408.1, R401.1, U401.5 (CSP1), U401.28 (IN); also elsewhere on the board
SGND: C401.2, C402.2, C403.2, C404.2, C405.2, C406.2, C407.2, C408.2, C409.2, C410.2, C411.2, C412.2, C415.2, C416.1, C417.1, C418.2, C419.-, C420.2, C421.-, C422.2, C423.-, C426.-, C427.2, C430.2, C431.2, J401.A1B12 (GND), J401.B1A12 (GND), J401.M1 (GND), J401.M2 (GND), J401.M3 (GND), J401.M4 (GND), Q402.1 (S), Q402.2 (S), Q402.3 (S), Q403.1 (S), Q403.2 (S), Q403.3 (S), R408.1, R411.2, R419.1, U401.3 (PGND), U401.7 (SHLD_SNS), U401.23 (AGND_2), U401.26 (AGND), U401.EP; also elsewhere on the board
USB2_!ALERT: R406.2, TP404.1, U401.20 (!ALERT); also elsewhere on the board
USB2_ADDR: R408.2, U401.34 (ADDR)
USB2_BIAS: C409.1, C410.1, D401.2 (A), D402.2 (A), U401.29 (BIAS)
USB2_BST1: C413.2, D401.1 (C), U401.1 (BST1)
USB2_BST2: C414.1, D402.1 (C), U401.36 (BST2)
USB2_CC1: C420.1, J401.A5 (CC1), TP405.1, U401.25 (HVCC1)
USB2_CC2: C422.1, J401.B5 (CC2), U401.24 (HVCC2)
USB2_CSN1: Q401.5-8 (D), R401.2, U401.4 (CSN1)
USB2_CSP2: C415.1, Q404.5-8 (D), R413.1, U401.33 (CSP2)
USB2_DH1: R403.1, U401.40 (DH1)
USB2_DH1_R: Q401.4 (G), R403.2, R405.1
USB2_DH2: R412.1, U401.37 (DH2)
USB2_DH2_R: Q404.4 (G), R412.2
USB2_DL1: R409.1, U401.2 (DL1)
USB2_DL1_R: Q402.4 (G), R409.2
USB2_DL2: R410.1, U401.35 (DL2)
USB2_DL2_R: Q403.4 (G), R410.2
USB2_DM: U401.19 (DM); also elsewhere on the board
USB2_DP: U401.18 (DP); also elsewhere on the board
USB2_EN: R407.1, TP401.1; also elsewhere on the board
USB2_GDRV: R411.1, U401.8 (GDRV)
USB2_HVDM: J401.A7 (DN1), J401.B7 (DN2), U401.21 (HVDM)
USB2_HVDP: J401.A6 (DP1), J401.B6 (DP2), U401.22 (HVDP)
USB2_HVEN: R407.2, U401.6 (HVEN)
USB2_ICOMP: C416.2, R414.1, U401.30 (ICOMP)
USB2_ICOMP_R: C417.2, R414.2
USB2_LX1: C413.1, L401.1, Q401.1 (S), Q401.2 (S), Q401.3 (S), Q402.5-8 (D), R405.2, U401.39 (LX1)
USB2_LX2: C414.2, L401.2, Q403.5-8 (D), Q404.1 (S), Q404.2 (S), Q404.3 (S), U401.38 (LX2)
USB2_OUT: C418.1, C419.+, C421.+, C423.+, C426.+, R413.2, R418.1, U401.32 (OUT)
USB2_SCL: R402.2, TP402.1, U401.11 (SCL); also elsewhere on the board
USB2_SDA: R404.2, TP403.1, U401.12 (SDA); also elsewhere on the board
USB2_VBUS: C431.1, J401.A4B9 (VBUS), J401.B4A9 (VBUS), R418.2, R419.2, TP406.1, U401.31 (CSN2)
USB2_VCOMP: C424.1, C425.1, R415.1, R416.1, U401.27 (VCOMP)
USB2_VCOMP_CPI: C424.2, C425.2, C427.1
USB2_VCOMP_CZI: C428.2, C429.2, C430.1
USB2_VCOMP_R: C428.1, C429.1, R417.2
USB2_VCOMP_RI: R415.2, R416.2, R417.1
USB2_VDD_BMC: C412.1, U401.13 (VDD_BMC)
USB2_VDD_USB: C411.1, U401.17 (VDD_USB)
USB_SYNC: U401.10 (SYNC); also elsewhere on the board

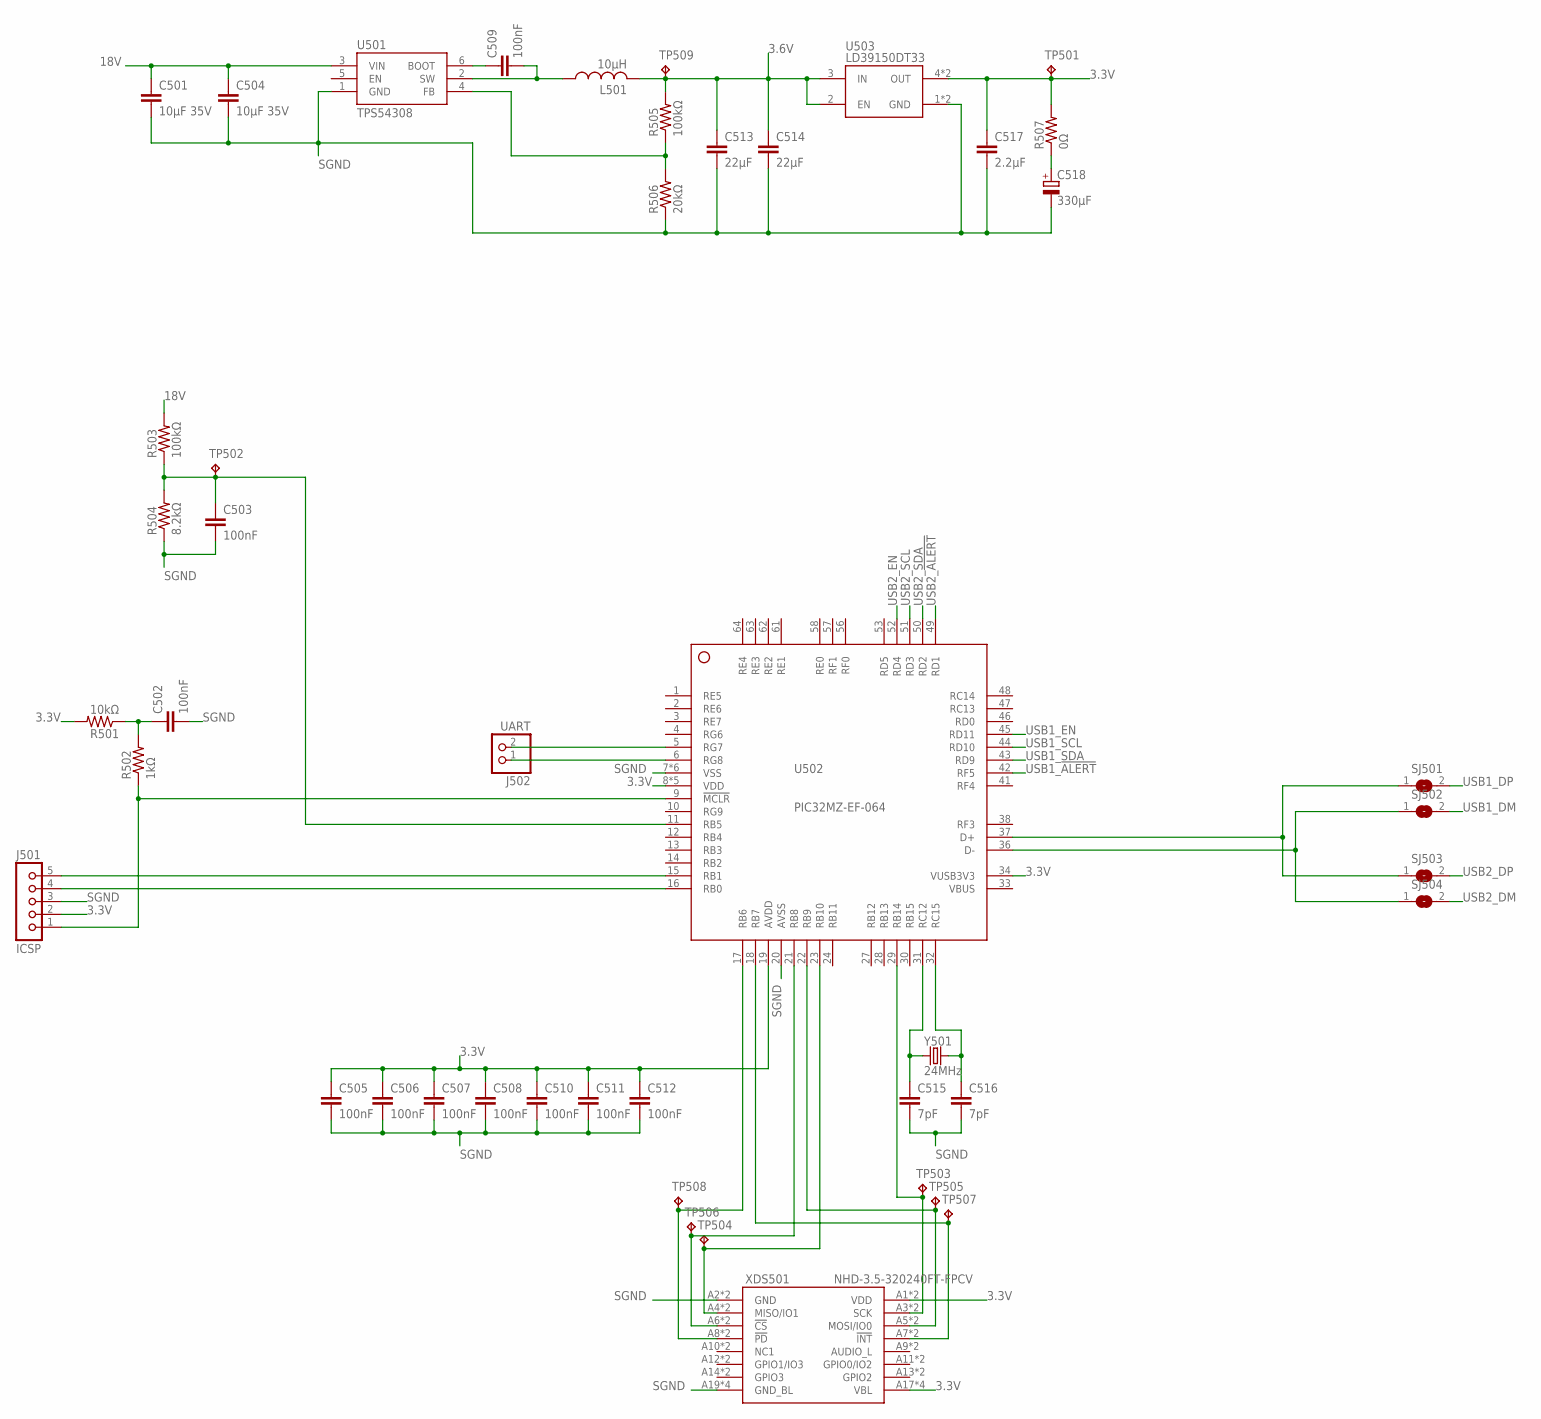
[picture p26: schematic main.sch, sheet 5]

Parts:
C501, C504: 10µF 35V; C1206
C502, C503, C505, C506, C507, C508, C509, C510, C511, C512: 100nF; C0603
C513, C514: 22µF; C0805
C515, C516: 7pF; C0603
C517: 2.2µF; C0805
C518: 330µF; PANASONIC_D
J501: ICSP; 5PIN-1.27
J502: UART; 1X02
L501: 10µH; RLB0912
R501: 10kΩ; R0603
R502: 1kΩ; R0603
R503, R505: 100kΩ; R0603
R504: 8.2kΩ; R0603
R506: 20kΩ; R0603
R507: 0Ω; R0603
SJ501, SJ502, SJ503, SJ504: SJ
TP501, TP502, TP503, TP504, TP505, TP506, TP507, TP508, TP509: RCU-0(J); TP_0603_JOINED
U501: TPS54308; SOT23-6L
U502: PIC32MZ-EF-064; TQFP64-10X10X1MM
U503: LD39150DT33; DFN6
XDS501: NHD-3.5-320240FT-FPCV; FFC3A20-20
Y501: 24MHz; XRCGB

Connections:
3.3V: C505.1, C506.1, C507.1, C508.1, C510.1, C511.1, C512.1, C517.1, J501.2, R501.2, R507.2, TP501.1, U502.8 (VDD), U502.19 (AVDD), U502.26 (VDD), U502.34 (VUSB3V3), U502.39 (VDD), U502.54 (VDD), U502.60 (VDD), U503.4 (OUT), U503.5 (OUT), XDS501.A1 (VDD), XDS501.A17 (VBL), XDS501.A18 (VBL), XDS501.B1 (VDD), XDS501.B17 (VBL), XDS501.B18 (VBL); also elsewhere on the board
3.3V_BULKR: C518.+, R507.1
3.6V: C513.1, C514.1, L501.2, R505.2, TP509.1, U503.2 (EN), U503.3 (IN)
18V: C501.1, C504.1, R503.2, U501.3 (VIN); also elsewhere on the board
LCD_!CS: TP506.1, U502.21 (RB8), XDS501.A6 (!CS), XDS501.B6 (!CS)
LCD_!INT: TP507.1, U502.18 (RB7), XDS501.A7 (!INT), XDS501.B7 (!INT)
LCD_!PD: TP508.1, U502.17 (RB6), XDS501.A8 (!PD), XDS501.B8 (!PD)
LCD_MISO: TP504.1, U502.23 (RB10), XDS501.A4 (MISO/IO1), XDS501.B4 (MISO/IO1)
LCD_MOSI: TP505.1, U502.22 (RB9), XDS501.A5 (MOSI/IO0), XDS501.B5 (MOSI/IO0)
LCD_SCK: TP503.1, U502.29 (RB14), XDS501.A3 (SCK), XDS501.B3 (SCK)
PIC_!MCLR: J501.1, R502.1, U502.9 (!MCLR)
PIC_!MCLR!_FILTER: C502.1, R501.1, R502.2
PIC_D+: SJ501.1, SJ503.1, U502.37 (D+)
PIC_D-: SJ502.1, SJ504.1, U502.36 (D-)
PIC_OSC1: C515.1, U502.31 (RC12), Y501.1
PIC_OSC2: C516.1, U502.32 (RC15), Y501.3 (2)
PIC_PGEC: J501.5, U502.15 (RB1)
PIC_PGED: J501.4, U502.16 (RB0)
PIC_UART_RX: J502.1, U502.6 (RG8)
PIC_UART_TX: J502.2, U502.5 (RG7)
PIC_VIN_SENSE: C503.1, R503.1, R504.2, TP502.1, U502.11 (RB5)
PRELIN_BOOT: C509.1, U501.6 (BOOT)
PRELIN_FB: R505.1, R506.2, U501.4 (FB)
PRELIN_SW: C509.2, L501.1, U501.2 (SW)
SGND: C501.2, C502.2, C503.2, C504.2, C505.2, C506.2, C507.2, C508.2, C510.2, C511.2, C512.2, C513.2, C514.2, C515.2, C516.2, C517.2, C518.-, J501.3, R504.1, R506.1, U501.1 (GND), U502.7 (VSS), U502.20 (AVSS), U502.25 (VSS), U502.35 (VSS), U502.40 (VSS), U502.55 (VSS), U502.59 (VSS), U503.1 (GND), U503.T (GND), XDS501.A2 (GND), XDS501.A19 (GND_BL), XDS501.A20 (GND_BL), XDS501.B2 (GND), XDS501.B19 (GND_BL), XDS501.B20 (GND_BL); also elsewhere on the board
USB1_!ALERT: U502.42 (RF5); also elsewhere on the board
USB1_DM: SJ502.2; also elsewhere on the board
USB1_DP: SJ501.2; also elsewhere on the board
USB1_EN: U502.45 (RD11); also elsewhere on the board
USB1_SCL: U502.44 (RD10); also elsewhere on the board
USB1_SDA: U502.43 (RD9); also elsewhere on the board
USB2_!ALERT: U502.49 (RD1); also elsewhere on the board
USB2_DM: SJ504.2; also elsewhere on the board
USB2_DP: SJ503.2; also elsewhere on the board
USB2_EN: U502.52 (RD4); also elsewhere on the board
USB2_SCL: U502.51 (RD3); also elsewhere on the board
USB2_SDA: U502.50 (RD2); also elsewhere on the board

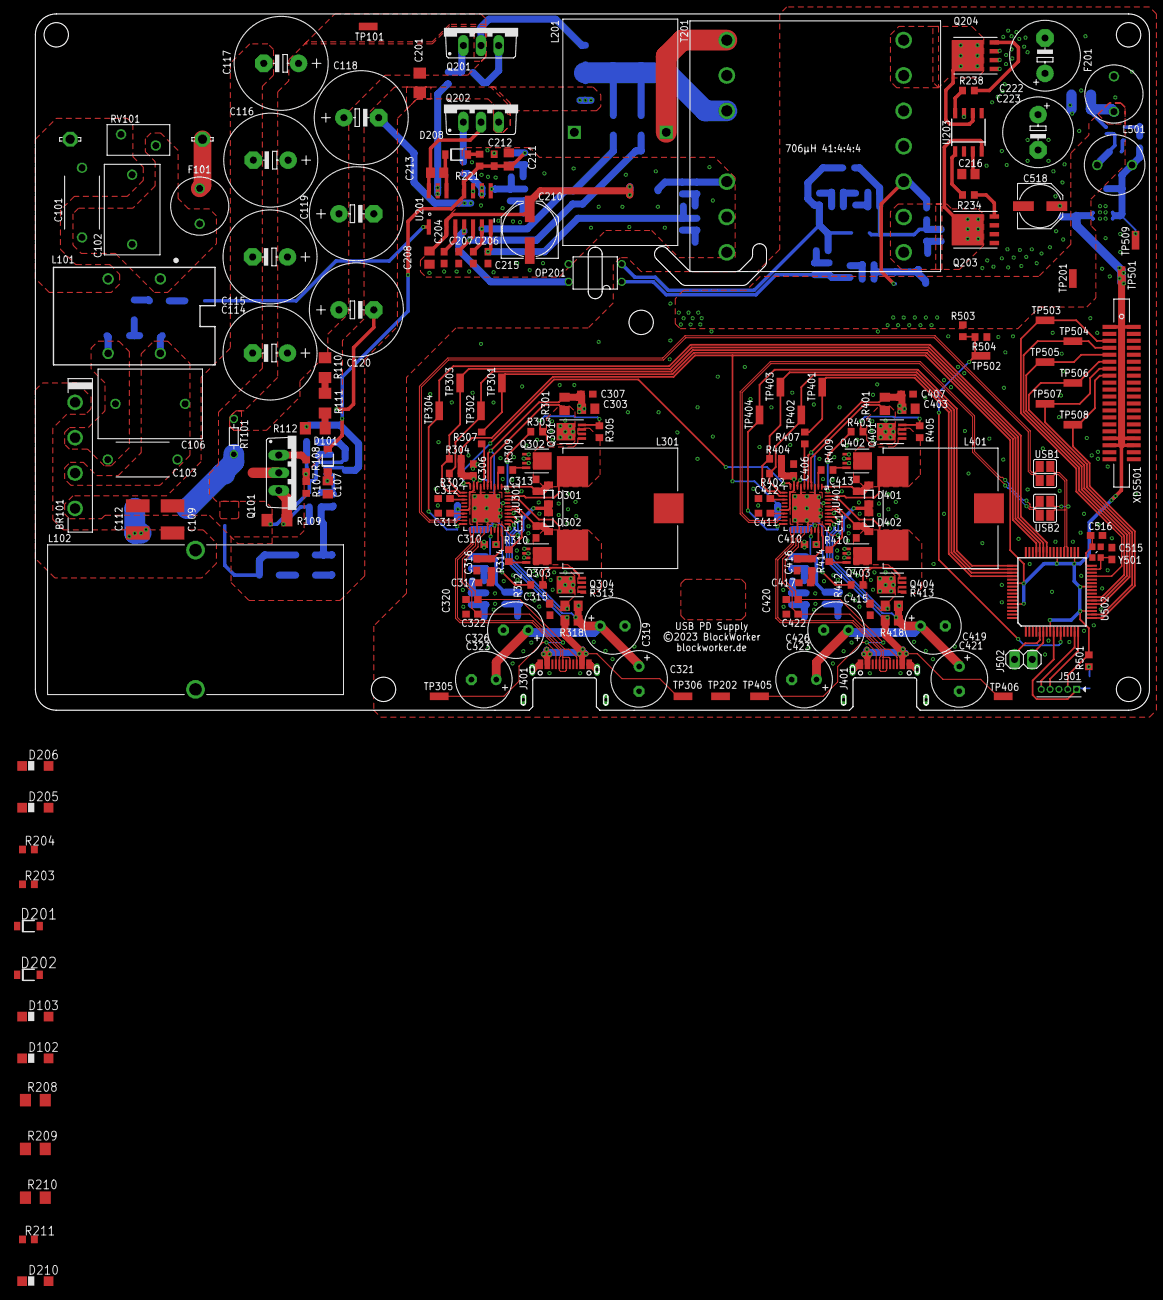
[picture p27: board main.brd from above]

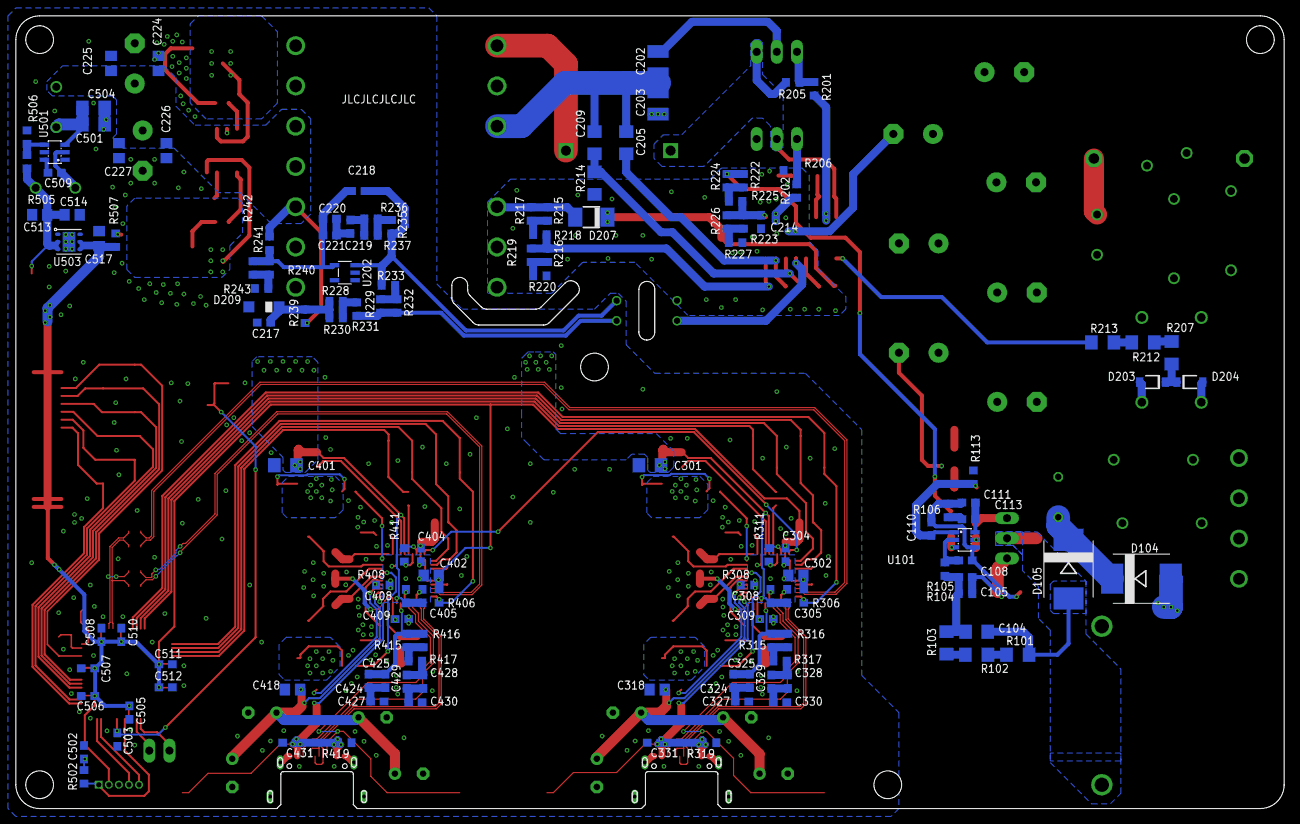
[picture p28: board main.brd from below]

Board: 2 copper layers, 160.0 x 100.0 mm, 318 parts (132 on the bottom side), 175 nets.
