BlockWorker/USBPD-Supply/adapter.brd

## EAGLE design adapter.brd (2023-05-07)

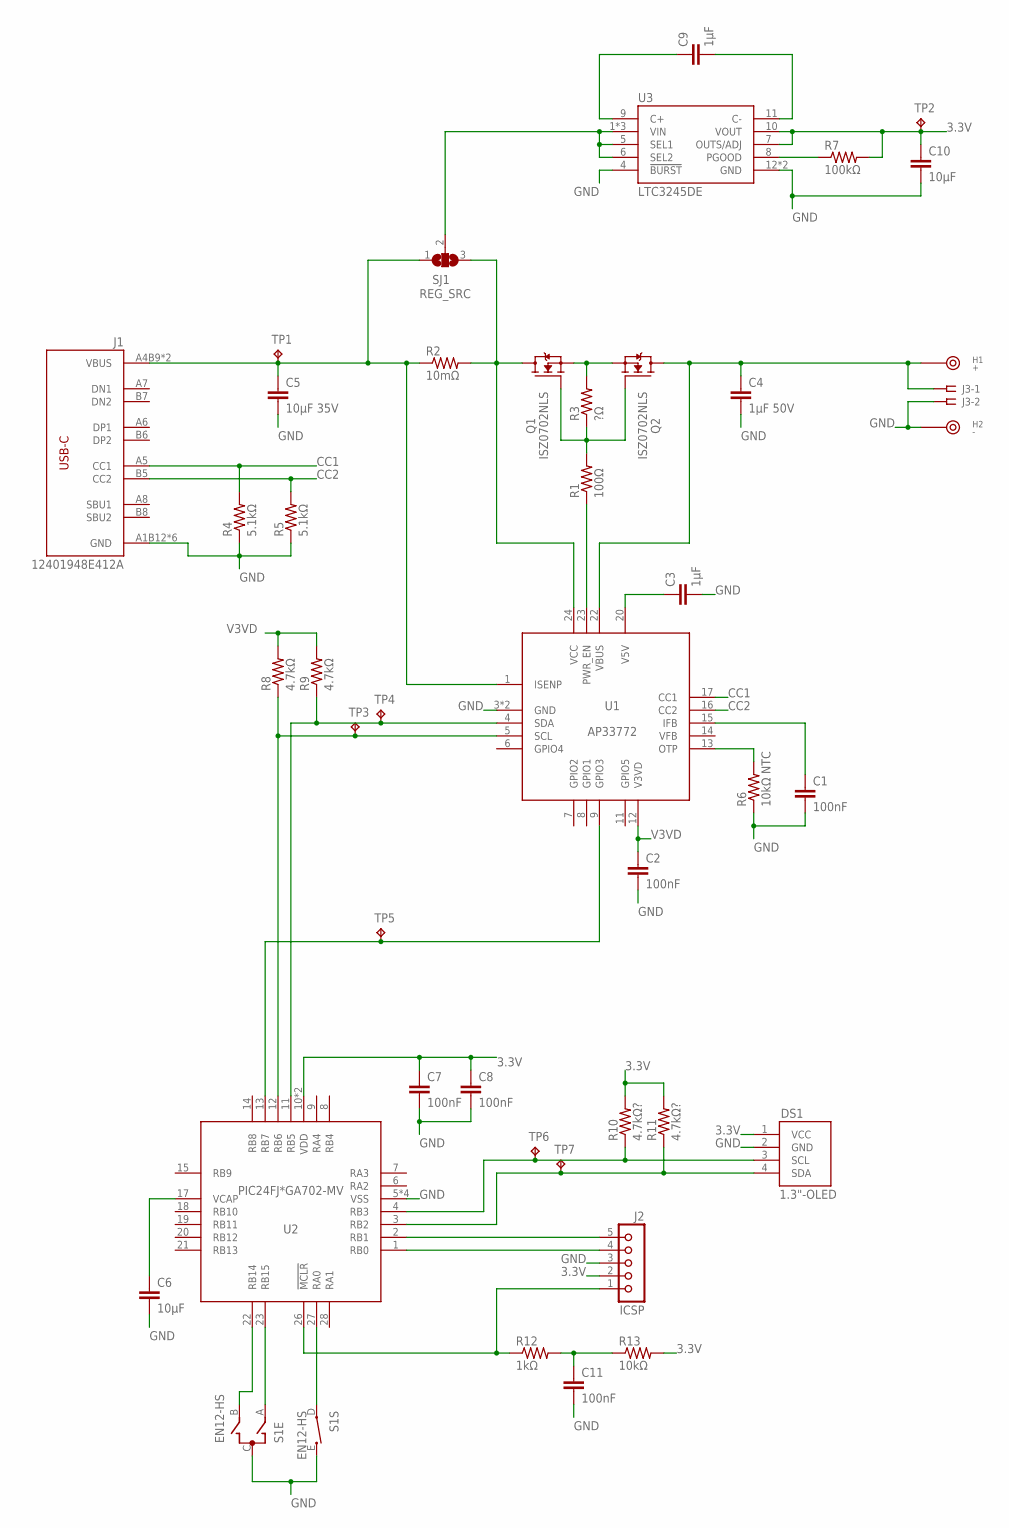
[picture p29: schematic adapter.sch]

Parts:
C1, C2, C7, C8, C11: 100nF; C0603
C3, C9: 1µF; C0603
C4: 1µF 50V; C0603
C5: 10µF 35V; C1206
C6, C10: 10µF; C0805
DS1: 1.3"-OLED
H1: +; 78614015360
H2: -; 78614015360
J1: 12401948E412A
J2: ICSP; 5PIN-1.27
J3: SSW-102-02-G-S-RA
Q1, Q2: ISZ0702NLS; TSDSON-8
R1: 100Ω; R0603
R2: 10mΩ; R1206
R3: ?Ω; R0603
R4, R5: 5.1kΩ; R0603
R6: 10kΩ NTC; R0603
R7: 100kΩ; R0603
R8, R9: 4.7kΩ; R0603
R10, R11: 4.7kΩ?; R0603
R12: 1kΩ; R0603
R13: 10kΩ; R0603
S1: EN12-HS
SJ1: REG_SRC; SJ_2
TP1, TP2, TP3, TP4, TP5, TP6, TP7: RCU-0(J); TP_0603_JOINED
U1: AP33772; QFN24-4X4
U2: PIC24FJ*GA702-MV; UQFN28_4X4MM
U3: LTC3245DE; DFN12

Connections:
3.3V: C7.1, C8.1, C10.1, DS1.1 (VCC), J2.2, R7.2, R10.2, R11.2, R13.2, TP2.1, U2.10 (VDD), U2.25 (VDD), U3.7 (OUTS/ADJ), U3.10 (VOUT)
!MCLR: J2.1, R12.1, U2.26 (!MCLR)
!MCLR!_FILTER: C11.1, R12.2, R13.1
C+: C9.1, U3.9 (C+)
C-: C9.2, U3.11 (C-)
CC1: J1.A5 (CC1), R4.2, U1.17 (CC1)
CC2: J1.B5 (CC2), R5.2, U1.16 (CC2)
ENC_A: S1.A, U2.23 (RB15)
ENC_B: S1.B, U2.22 (RB14)
ENC_SW: S1.D (1), U2.27 (RA0)
GND: C1.2, C2.2, C3.2, C4.2, C5.2, C6.2, C7.2, C8.2, C10.2, C11.2, DS1.2 (GND), H2.M, J1.A1B12 (GND), J1.B1A12 (GND), J1.M1 (GND), J1.M2 (GND), J1.M3 (GND), J1.M4 (GND), J2.3, J3.2, R4.1, R5.1, R6.1, S1.C, S1.E (2), U1.3 (GND), U1.EXP (GND), U2.5 (VSS), U2.16 (VSS), U2.24 (VSS), U2.TH (VSS), U3.4 (!BURST), U3.12 (GND), U3.EXP (GND)
IFB: C1.1, U1.15 (IFB)
OLED_SCL: DS1.3 (SCL), R10.1, TP6.1, U2.4 (RB3)
OLED_SDA: DS1.4 (SDA), R11.1, TP7.1, U2.3 (RB2)
OTP: R6.2, U1.13 (OTP)
PGC: J2.5, U2.2 (RB1)
PGD: J2.4, U2.1 (RB0)
PWR_EN: R1.1, U1.23 (PWR_EN)
PWR_EN_R: Q1.4 (G), Q2.4 (G), R1.2, R3.1
REG_PGOOD: R7.1, U3.8 (PGOOD)
REG_VIN: SJ1.2, U3.1 (VIN), U3.2 (VIN), U3.3 (VIN), U3.5 (SEL1), U3.6 (SEL2)
USB_INT: TP5.1, U1.9 (GPIO3), U2.13 (RB7)
USB_SCL: R8.1, TP3.1, U1.5 (SCL), U2.12 (RB6)
USB_SDA: R9.1, TP4.1, U1.4 (SDA), U2.11 (RB5)
V3VD: C2.1, R8.2, R9.2, U1.12 (V3VD)
V5V: C3.1, U1.20 (V5V)
VBUS_IN: C5.1, J1.A4B9 (VBUS), J1.B4A9 (VBUS), R2.1, SJ1.1, TP1.1, U1.1 (ISENP)
VBUS_IN_R: Q1.5-8 (D), R2.2, SJ1.3, U1.24 (VCC)
VBUS_OUT: C4.1, H1.M, J3.1, Q2.5-8 (D), U1.22 (VBUS)
VBUS_SW: Q1.1 (S), Q1.2 (S), Q1.3 (S), Q2.1 (S), Q2.2 (S), Q2.3 (S), R3.2
VCAP: C6.1, U2.17 (VCAP)

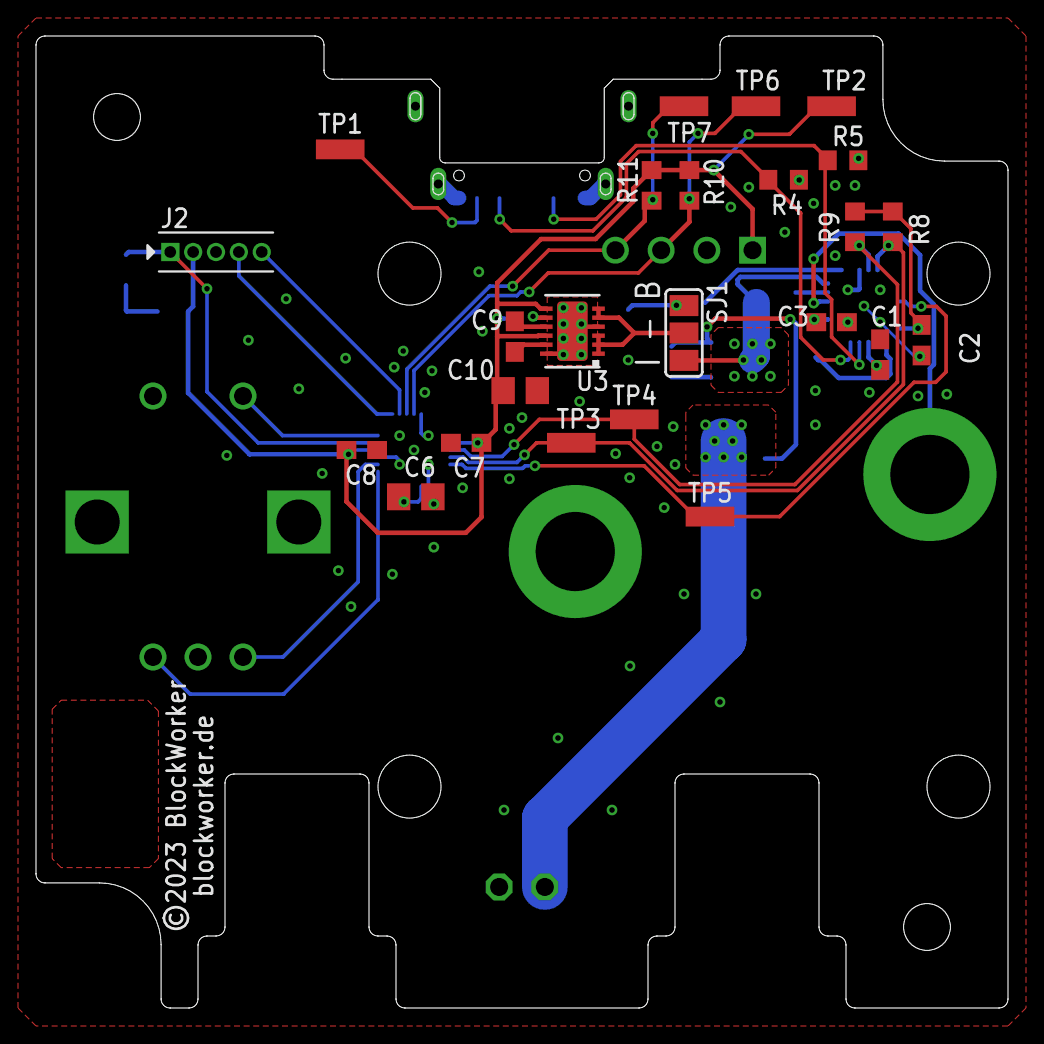
[picture p30: board adapter.brd from above]

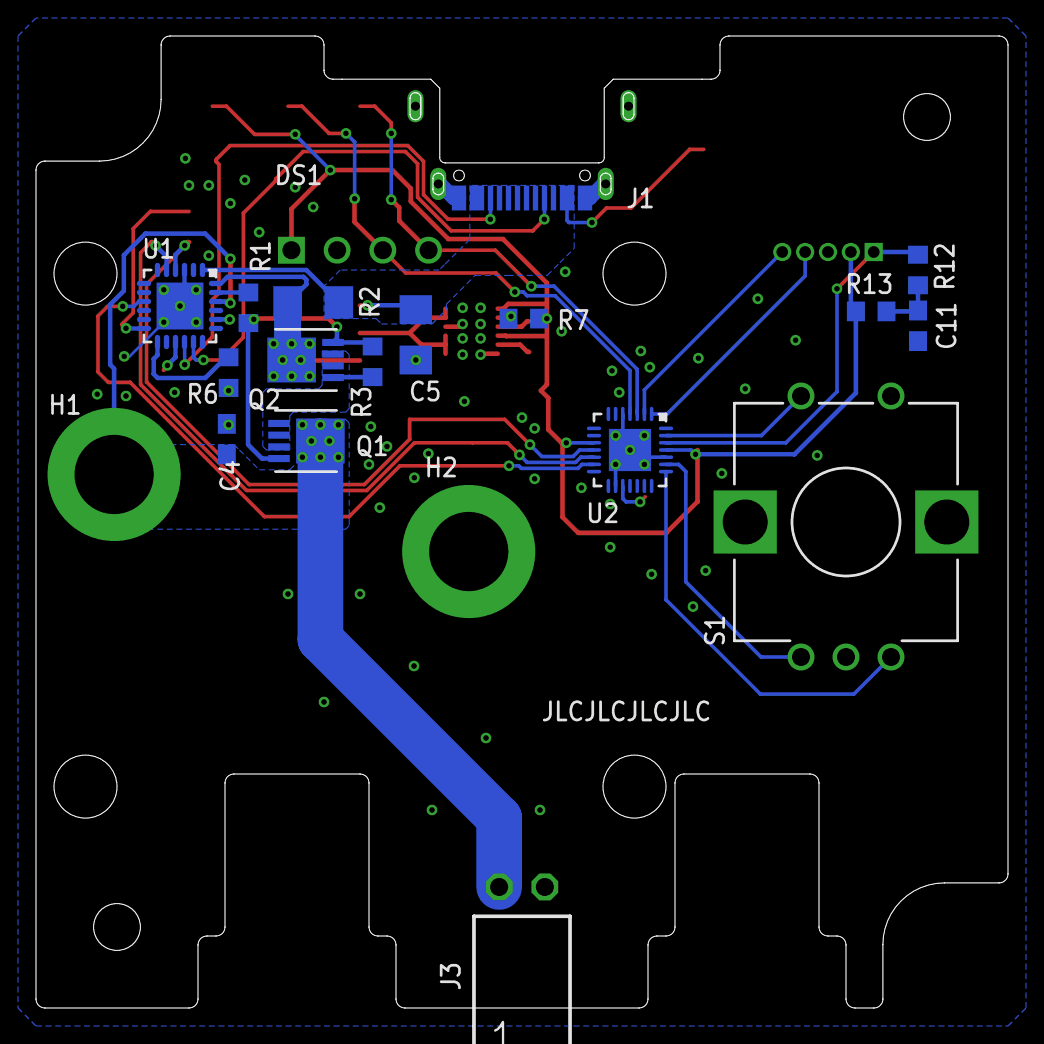
[picture p31: board adapter.brd from below]

Board: 2 copper layers, 54.0 x 54.0 mm, 44 parts (20 on the bottom side), 31 nets.
