BlockWorker/USBPD-Supply/adapter/USBPD-Adapter.X/main.c

/**
  Generated main.c file from MPLAB Code Configurator

  @Company
    Microchip Technology Inc.

  @File Name
    main.c

  @Summary
    This is the generated main.c using PIC24 / dsPIC33 / PIC32MM MCUs.

  @Description
    This source file provides main entry point for system initialization and application code development.
    Generation Information :
        Product Revision  :  PIC24 / dsPIC33 / PIC32MM MCUs - 1.171.1
        Device            :  PIC24FJ128GA702
    The generated drivers are tested against the following:
        Compiler          :  XC16 v1.70
        MPLAB 	          :  MPLAB X v5.50
*/

/*
    (c) 2020 Microchip Technology Inc. and its subsidiaries. You may use this
    software and any derivatives exclusively with Microchip products.

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
    IN NO EVENT WILL MICROCHIP BE LIABLE FOR ANY INDIRECT, SPECIAL, PUNITIVE,
    INCIDENTAL OR CONSEQUENTIAL LOSS, DAMAGE, COST OR EXPENSE OF ANY KIND
    WHATSOEVER RELATED TO THE SOFTWARE, HOWEVER CAUSED, EVEN IF MICROCHIP HAS
    BEEN ADVISED OF THE POSSIBILITY OR THE DAMAGES ARE FORESEEABLE. TO THE
    FULLEST EXTENT ALLOWED BY LAW, MICROCHIP'S TOTAL LIABILITY ON ALL CLAIMS IN
    ANY WAY RELATED TO THIS SOFTWARE WILL NOT EXCEED THE AMOUNT OF FEES, IF ANY,
    THAT YOU HAVE PAID DIRECTLY TO MICROCHIP FOR THIS SOFTWARE.

    MICROCHIP PROVIDES THIS SOFTWARE CONDITIONALLY UPON YOUR ACCEPTANCE OF THESE
    TERMS.
*/

/**
  Section: Included Files
*/
#include "mcc_generated_files/system.h"
#include "oled.h"
#include "util.h"
#include "ui.h"
#include "ap33772.h"


#define SCREEN_UPDATE_PERIOD 100000


static uint64_t last_screen_update = 0;


static void _halt_error() {
    #ifdef __DEBUG    
        __builtin_software_breakpoint();
    #endif
    while(1);
}


/*
                         Main application
 */
int main(void) {
    // initialize the device
    SYSTEM_Initialize();

    AP_Initialize();
    UI_Initialize();
    
    bool init_success = false;
    uint8_t i;
    for (i = 0; i < 10; i++) {
        if (OLED_Initialize()) {
            init_success = true;
            break;
        }
    }
    if (!init_success) _halt_error();

    while (1) {
        UTIL_UpdateCurrentTime();
        
        AP_Tasks();
        UI_Tasks();
        
        if (util_currentTimeMicroseconds - last_screen_update >= SCREEN_UPDATE_PERIOD) {
            last_screen_update = util_currentTimeMicroseconds;
            OLED_UpdateScreen();
        }
    }

    return 1;
}
/**
 End of File
*/
