BlockWorker/USBPD-Supply/adapter/USBPD-Adapter.X/mcc_generated_files/pin_manager.h

/**
  PIN MANAGER Generated Driver File

  @Company:
    Microchip Technology Inc.

  @File Name:
    pin_manager.h

  @Summary:
    This is the generated manager file for the PIC24 / dsPIC33 / PIC32MM MCUs device.  This manager
    configures the pins direction, initial state, analog setting.
    The peripheral pin select, PPS, configuration is also handled by this manager.

  @Description:
    This source file provides implementations for PIN MANAGER.
    Generation Information :
        Product Revision  :  PIC24 / dsPIC33 / PIC32MM MCUs - 1.171.1
        Device            :  PIC24FJ128GA702
    The generated drivers are tested against the following:
        Compiler          :  XC16 v1.70
        MPLAB 	          :  MPLAB X v5.50
*/

/*
    (c) 2020 Microchip Technology Inc. and its subsidiaries. You may use this
    software and any derivatives exclusively with Microchip products.

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
    IN NO EVENT WILL MICROCHIP BE LIABLE FOR ANY INDIRECT, SPECIAL, PUNITIVE,
    INCIDENTAL OR CONSEQUENTIAL LOSS, DAMAGE, COST OR EXPENSE OF ANY KIND
    WHATSOEVER RELATED TO THE SOFTWARE, HOWEVER CAUSED, EVEN IF MICROCHIP HAS
    BEEN ADVISED OF THE POSSIBILITY OR THE DAMAGES ARE FORESEEABLE. TO THE
    FULLEST EXTENT ALLOWED BY LAW, MICROCHIP'S TOTAL LIABILITY ON ALL CLAIMS IN
    ANY WAY RELATED TO THIS SOFTWARE WILL NOT EXCEED THE AMOUNT OF FEES, IF ANY,
    THAT YOU HAVE PAID DIRECTLY TO MICROCHIP FOR THIS SOFTWARE.

    MICROCHIP PROVIDES THIS SOFTWARE CONDITIONALLY UPON YOUR ACCEPTANCE OF THESE
    TERMS.
*/

#ifndef _PIN_MANAGER_H
#define _PIN_MANAGER_H
/**
    Section: Includes
*/
#include <xc.h>

/**
    Section: Device Pin Macros
*/
/**
  @Summary
    Sets the GPIO pin, RA0, high using LATA0.

  @Description
    Sets the GPIO pin, RA0, high using LATA0.

  @Preconditions
    The RA0 must be set to an output.

  @Returns
    None.

  @Param
    None.

  @Example
    <code>
    // Set RA0 high (1)
    ENC_SW_SetHigh();
    </code>

*/
#define ENC_SW_SetHigh()          (_LATA0 = 1)
/**
  @Summary
    Sets the GPIO pin, RA0, low using LATA0.

  @Description
    Sets the GPIO pin, RA0, low using LATA0.

  @Preconditions
    The RA0 must be set to an output.

  @Returns
    None.

  @Param
    None.

  @Example
    <code>
    // Set RA0 low (0)
    ENC_SW_SetLow();
    </code>

*/
#define ENC_SW_SetLow()           (_LATA0 = 0)
/**
  @Summary
    Toggles the GPIO pin, RA0, using LATA0.

  @Description
    Toggles the GPIO pin, RA0, using LATA0.

  @Preconditions
    The RA0 must be set to an output.

  @Returns
    None.

  @Param
    None.

  @Example
    <code>
    // Toggle RA0
    ENC_SW_Toggle();
    </code>

*/
#define ENC_SW_Toggle()           (_LATA0 ^= 1)
/**
  @Summary
    Reads the value of the GPIO pin, RA0.

  @Description
    Reads the value of the GPIO pin, RA0.

  @Preconditions
    None.

  @Returns
    None.

  @Param
    None.

  @Example
    <code>
    uint16_t portValue;

    // Read RA0
    postValue = ENC_SW_GetValue();
    </code>

*/
#define ENC_SW_GetValue()         _RA0
/**
  @Summary
    Configures the GPIO pin, RA0, as an input.

  @Description
    Configures the GPIO pin, RA0, as an input.

  @Preconditions
    None.

  @Returns
    None.

  @Param
    None.

  @Example
    <code>
    // Sets the RA0 as an input
    ENC_SW_SetDigitalInput();
    </code>

*/
#define ENC_SW_SetDigitalInput()  (_TRISA0 = 1)
/**
  @Summary
    Configures the GPIO pin, RA0, as an output.

  @Description
    Configures the GPIO pin, RA0, as an output.

  @Preconditions
    None.

  @Returns
    None.

  @Param
    None.

  @Example
    <code>
    // Sets the RA0 as an output
    ENC_SW_SetDigitalOutput();
    </code>

*/
#define ENC_SW_SetDigitalOutput() (_TRISA0 = 0)
/**
  @Summary
    Sets the GPIO pin, RB14, high using LATB14.

  @Description
    Sets the GPIO pin, RB14, high using LATB14.

  @Preconditions
    The RB14 must be set to an output.

  @Returns
    None.

  @Param
    None.

  @Example
    <code>
    // Set RB14 high (1)
    ENC_B_SetHigh();
    </code>

*/
#define ENC_B_SetHigh()          (_LATB14 = 1)
/**
  @Summary
    Sets the GPIO pin, RB14, low using LATB14.

  @Description
    Sets the GPIO pin, RB14, low using LATB14.

  @Preconditions
    The RB14 must be set to an output.

  @Returns
    None.

  @Param
    None.

  @Example
    <code>
    // Set RB14 low (0)
    ENC_B_SetLow();
    </code>

*/
#define ENC_B_SetLow()           (_LATB14 = 0)
/**
  @Summary
    Toggles the GPIO pin, RB14, using LATB14.

  @Description
    Toggles the GPIO pin, RB14, using LATB14.

  @Preconditions
    The RB14 must be set to an output.

  @Returns
    None.

  @Param
    None.

  @Example
    <code>
    // Toggle RB14
    ENC_B_Toggle();
    </code>

*/
#define ENC_B_Toggle()           (_LATB14 ^= 1)
/**
  @Summary
    Reads the value of the GPIO pin, RB14.

  @Description
    Reads the value of the GPIO pin, RB14.

  @Preconditions
    None.

  @Returns
    None.

  @Param
    None.

  @Example
    <code>
    uint16_t portValue;

    // Read RB14
    postValue = ENC_B_GetValue();
    </code>

*/
#define ENC_B_GetValue()         _RB14
/**
  @Summary
    Configures the GPIO pin, RB14, as an input.

  @Description
    Configures the GPIO pin, RB14, as an input.

  @Preconditions
    None.

  @Returns
    None.

  @Param
    None.

  @Example
    <code>
    // Sets the RB14 as an input
    ENC_B_SetDigitalInput();
    </code>

*/
#define ENC_B_SetDigitalInput()  (_TRISB14 = 1)
/**
  @Summary
    Configures the GPIO pin, RB14, as an output.

  @Description
    Configures the GPIO pin, RB14, as an output.

  @Preconditions
    None.

  @Returns
    None.

  @Param
    None.

  @Example
    <code>
    // Sets the RB14 as an output
    ENC_B_SetDigitalOutput();
    </code>

*/
#define ENC_B_SetDigitalOutput() (_TRISB14 = 0)
/**
  @Summary
    Sets the GPIO pin, RB15, high using LATB15.

  @Description
    Sets the GPIO pin, RB15, high using LATB15.

  @Preconditions
    The RB15 must be set to an output.

  @Returns
    None.

  @Param
    None.

  @Example
    <code>
    // Set RB15 high (1)
    ENC_A_SetHigh();
    </code>

*/
#define ENC_A_SetHigh()          (_LATB15 = 1)
/**
  @Summary
    Sets the GPIO pin, RB15, low using LATB15.

  @Description
    Sets the GPIO pin, RB15, low using LATB15.

  @Preconditions
    The RB15 must be set to an output.

  @Returns
    None.

  @Param
    None.

  @Example
    <code>
    // Set RB15 low (0)
    ENC_A_SetLow();
    </code>

*/
#define ENC_A_SetLow()           (_LATB15 = 0)
/**
  @Summary
    Toggles the GPIO pin, RB15, using LATB15.

  @Description
    Toggles the GPIO pin, RB15, using LATB15.

  @Preconditions
    The RB15 must be set to an output.

  @Returns
    None.

  @Param
    None.

  @Example
    <code>
    // Toggle RB15
    ENC_A_Toggle();
    </code>

*/
#define ENC_A_Toggle()           (_LATB15 ^= 1)
/**
  @Summary
    Reads the value of the GPIO pin, RB15.

  @Description
    Reads the value of the GPIO pin, RB15.

  @Preconditions
    None.

  @Returns
    None.

  @Param
    None.

  @Example
    <code>
    uint16_t portValue;

    // Read RB15
    postValue = ENC_A_GetValue();
    </code>

*/
#define ENC_A_GetValue()         _RB15
/**
  @Summary
    Configures the GPIO pin, RB15, as an input.

  @Description
    Configures the GPIO pin, RB15, as an input.

  @Preconditions
    None.

  @Returns
    None.

  @Param
    None.

  @Example
    <code>
    // Sets the RB15 as an input
    ENC_A_SetDigitalInput();
    </code>

*/
#define ENC_A_SetDigitalInput()  (_TRISB15 = 1)
/**
  @Summary
    Configures the GPIO pin, RB15, as an output.

  @Description
    Configures the GPIO pin, RB15, as an output.

  @Preconditions
    None.

  @Returns
    None.

  @Param
    None.

  @Example
    <code>
    // Sets the RB15 as an output
    ENC_A_SetDigitalOutput();
    </code>

*/
#define ENC_A_SetDigitalOutput() (_TRISB15 = 0)
/**
  @Summary
    Sets the GPIO pin, RB7, high using LATB7.

  @Description
    Sets the GPIO pin, RB7, high using LATB7.

  @Preconditions
    The RB7 must be set to an output.

  @Returns
    None.

  @Param
    None.

  @Example
    <code>
    // Set RB7 high (1)
    USB_INT_SetHigh();
    </code>

*/
#define USB_INT_SetHigh()          (_LATB7 = 1)
/**
  @Summary
    Sets the GPIO pin, RB7, low using LATB7.

  @Description
    Sets the GPIO pin, RB7, low using LATB7.

  @Preconditions
    The RB7 must be set to an output.

  @Returns
    None.

  @Param
    None.

  @Example
    <code>
    // Set RB7 low (0)
    USB_INT_SetLow();
    </code>

*/
#define USB_INT_SetLow()           (_LATB7 = 0)
/**
  @Summary
    Toggles the GPIO pin, RB7, using LATB7.

  @Description
    Toggles the GPIO pin, RB7, using LATB7.

  @Preconditions
    The RB7 must be set to an output.

  @Returns
    None.

  @Param
    None.

  @Example
    <code>
    // Toggle RB7
    USB_INT_Toggle();
    </code>

*/
#define USB_INT_Toggle()           (_LATB7 ^= 1)
/**
  @Summary
    Reads the value of the GPIO pin, RB7.

  @Description
    Reads the value of the GPIO pin, RB7.

  @Preconditions
    None.

  @Returns
    None.

  @Param
    None.

  @Example
    <code>
    uint16_t portValue;

    // Read RB7
    postValue = USB_INT_GetValue();
    </code>

*/
#define USB_INT_GetValue()         _RB7
/**
  @Summary
    Configures the GPIO pin, RB7, as an input.

  @Description
    Configures the GPIO pin, RB7, as an input.

  @Preconditions
    None.

  @Returns
    None.

  @Param
    None.

  @Example
    <code>
    // Sets the RB7 as an input
    USB_INT_SetDigitalInput();
    </code>

*/
#define USB_INT_SetDigitalInput()  (_TRISB7 = 1)
/**
  @Summary
    Configures the GPIO pin, RB7, as an output.

  @Description
    Configures the GPIO pin, RB7, as an output.

  @Preconditions
    None.

  @Returns
    None.

  @Param
    None.

  @Example
    <code>
    // Sets the RB7 as an output
    USB_INT_SetDigitalOutput();
    </code>

*/
#define USB_INT_SetDigitalOutput() (_TRISB7 = 0)

/**
    Section: Function Prototypes
*/
/**
  @Summary
    Configures the pin settings of the PIC24FJ128GA702
    The peripheral pin select, PPS, configuration is also handled by this manager.

  @Description
    This is the generated manager file for the PIC24 / dsPIC33 / PIC32MM MCUs device.  This manager
    configures the pins direction, initial state, analog setting.
    The peripheral pin select, PPS, configuration is also handled by this manager.

  @Preconditions
    None.

  @Returns
    None.

  @Param
    None.

  @Example
    <code>
    void SYSTEM_Initialize(void)
    {
        // Other initializers are called from this function
        PIN_MANAGER_Initialize();
    }
    </code>

*/
void PIN_MANAGER_Initialize (void);

/**
  @Summary
    Callback for ENC_SW Pin.

  @Description
    This routine is callback for ENC_SW Pin

  @Param
    None.

  @Returns
    None
 
 
  @Example 
    <code>
        ENC_SW_SetInterruptHandler(&ENC_SW_CallBack);
    </code>
*/
void ENC_SW_CallBack(void);

/**
  @Summary
    Callback for USB_INT Pin.

  @Description
    This routine is callback for USB_INT Pin

  @Param
    None.

  @Returns
    None
 
 
  @Example 
    <code>
        USB_INT_SetInterruptHandler(&USB_INT_CallBack);
    </code>
*/
void USB_INT_CallBack(void);

/**
  @Summary
    Callback for ENC_A Pin.

  @Description
    This routine is callback for ENC_A Pin

  @Param
    None.

  @Returns
    None
 
 
  @Example 
    <code>
        ENC_A_SetInterruptHandler(&ENC_A_CallBack);
    </code>
*/
void ENC_A_CallBack(void);


/**
  @Summary
    Assigns a function pointer with a callback address.

  @Description
    This routine assigns a function pointer with a callback address.

  @Param
    Address of the callback routine.

  @Returns
    None
 
  @Example 
    <code>
        ENC_SW_SetInterruptHandler(&ENC_SW_CallBack);
    </code>
*/
void ENC_SW_SetInterruptHandler(void (* InterruptHandler)(void));

/**
  @Summary
    Assigns a function pointer with a callback address.

  @Description
    This routine assigns a function pointer with a callback address.

  @Param
    Address of the callback routine.

  @Returns
    None
 
  @Example 
    <code>
        ENC_SW_SetIOCInterruptHandler(&ENC_SW_CallBack);
    </code>
*/
void __attribute__((deprecated("\nThis will be removed in future MCC releases. \nUse ENC_SW_SetInterruptHandler instead."))) ENC_SW_SetIOCInterruptHandler(void *handler);

/**
  @Summary
    Assigns a function pointer with a callback address.

  @Description
    This routine assigns a function pointer with a callback address.

  @Param
    Address of the callback routine.

  @Returns
    None
 
  @Example 
    <code>
        USB_INT_SetInterruptHandler(&USB_INT_CallBack);
    </code>
*/
void USB_INT_SetInterruptHandler(void (* InterruptHandler)(void));

/**
  @Summary
    Assigns a function pointer with a callback address.

  @Description
    This routine assigns a function pointer with a callback address.

  @Param
    Address of the callback routine.

  @Returns
    None
 
  @Example 
    <code>
        USB_INT_SetIOCInterruptHandler(&USB_INT_CallBack);
    </code>
*/
void __attribute__((deprecated("\nThis will be removed in future MCC releases. \nUse USB_INT_SetInterruptHandler instead."))) USB_INT_SetIOCInterruptHandler(void *handler);

/**
  @Summary
    Assigns a function pointer with a callback address.

  @Description
    This routine assigns a function pointer with a callback address.

  @Param
    Address of the callback routine.

  @Returns
    None
 
  @Example 
    <code>
        ENC_A_SetInterruptHandler(&ENC_A_CallBack);
    </code>
*/
void ENC_A_SetInterruptHandler(void (* InterruptHandler)(void));

/**
  @Summary
    Assigns a function pointer with a callback address.

  @Description
    This routine assigns a function pointer with a callback address.

  @Param
    Address of the callback routine.

  @Returns
    None
 
  @Example 
    <code>
        ENC_A_SetIOCInterruptHandler(&ENC_A_CallBack);
    </code>
*/
void __attribute__((deprecated("\nThis will be removed in future MCC releases. \nUse ENC_A_SetInterruptHandler instead."))) ENC_A_SetIOCInterruptHandler(void *handler);


#endif
