BlockWorker/USBPD-Supply/firmware/src/config/default/initialization.c

/*******************************************************************************
  System Initialization File

  File Name:
    initialization.c

  Summary:
    This file contains source code necessary to initialize the system.

  Description:
    This file contains source code necessary to initialize the system.  It
    implements the "SYS_Initialize" function, defines the configuration bits,
    and allocates any necessary global system resources,
 *******************************************************************************/

// DOM-IGNORE-BEGIN
/*******************************************************************************
* Copyright (C) 2018 Microchip Technology Inc. and its subsidiaries.
*
* Subject to your compliance with these terms, you may use Microchip software
* and any derivatives exclusively with Microchip products. It is your
* responsibility to comply with third party license terms applicable to your
* use of third party software (including open source software) that may
* accompany Microchip software.
*
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
* IN NO EVENT WILL MICROCHIP BE LIABLE FOR ANY INDIRECT, SPECIAL, PUNITIVE,
* INCIDENTAL OR CONSEQUENTIAL LOSS, DAMAGE, COST OR EXPENSE OF ANY KIND
* WHATSOEVER RELATED TO THE SOFTWARE, HOWEVER CAUSED, EVEN IF MICROCHIP HAS
* BEEN ADVISED OF THE POSSIBILITY OR THE DAMAGES ARE FORESEEABLE. TO THE
* FULLEST EXTENT ALLOWED BY LAW, MICROCHIP'S TOTAL LIABILITY ON ALL CLAIMS IN
* ANY WAY RELATED TO THIS SOFTWARE WILL NOT EXCEED THE AMOUNT OF FEES, IF ANY,
* THAT YOU HAVE PAID DIRECTLY TO MICROCHIP FOR THIS SOFTWARE.
 *******************************************************************************/
// DOM-IGNORE-END

// *****************************************************************************
// *****************************************************************************
// Section: Included Files
// *****************************************************************************
// *****************************************************************************
#include "configuration.h"
#include "definitions.h"
#include "device.h"



// ****************************************************************************
// ****************************************************************************
// Section: Configuration Bits
// ****************************************************************************
// ****************************************************************************

/*** DEVCFG0 ***/
#pragma config DEBUG =      OFF
#pragma config JTAGEN =     OFF
#pragma config ICESEL =     ICS_PGx1
#pragma config TRCEN =      OFF
#pragma config BOOTISA =    MIPS32
#pragma config FECCCON =    OFF_UNLOCKED
#pragma config FSLEEP =     OFF
#pragma config DBGPER =     PG_ALL
#pragma config SMCLR =      MCLR_NORM
#pragma config SOSCGAIN =   GAIN_LEVEL_3
#pragma config SOSCBOOST =  ON
#pragma config POSCGAIN =   GAIN_LEVEL_3
#pragma config POSCBOOST =  ON
#pragma config EJTAGBEN =   NORMAL
#pragma config CP =         OFF

/*** DEVCFG1 ***/
#pragma config FNOSC =      SPLL
#pragma config DMTINTV =    WIN_127_128
#pragma config FSOSCEN =    OFF
#pragma config IESO =       OFF
#pragma config POSCMOD =    HS
#pragma config OSCIOFNC =   OFF
#pragma config FCKSM =      CSECME
#pragma config WDTPS =      PS1048576
#pragma config WDTSPGM =    STOP
#pragma config FWDTEN =     OFF
#pragma config WINDIS =     NORMAL
#pragma config FWDTWINSZ =  WINSZ_25
#pragma config DMTCNT =     DMT31
#pragma config FDMTEN =     OFF

/*** DEVCFG2 ***/
#pragma config FPLLIDIV =   DIV_3
#pragma config FPLLRNG =    RANGE_5_10_MHZ
#pragma config FPLLICLK =   PLL_POSC
#pragma config FPLLMULT =   MUL_50
#pragma config FPLLODIV =   DIV_2
#pragma config UPLLFSEL =   FREQ_24MHZ

/*** DEVCFG3 ***/
#pragma config USERID =     0xffff
#pragma config FMIIEN =     ON
#pragma config FETHIO =     ON
#pragma config PGL1WAY =    ON
#pragma config PMDL1WAY =   ON
#pragma config IOL1WAY =    ON
#pragma config FUSBIDIO =   OFF

/*** BF1SEQ0 ***/

#pragma config TSEQ =       0xffff
#pragma config CSEQ =       0x0





// *****************************************************************************
// *****************************************************************************
// Section: Driver Initialization Data
// *****************************************************************************
// *****************************************************************************
// <editor-fold defaultstate="collapsed" desc="DRV_I2C Instance 0 Initialization Data">

/* I2C Client Objects Pool */
static DRV_I2C_CLIENT_OBJ drvI2C0ClientObjPool[DRV_I2C_CLIENTS_NUMBER_IDX0];

/* I2C Transfer Objects Pool */
static DRV_I2C_TRANSFER_OBJ drvI2C0TransferObj[DRV_I2C_QUEUE_SIZE_IDX0];

/* I2C PLib Interface Initialization */
const DRV_I2C_PLIB_INTERFACE drvI2C0PLibAPI = {

    /* I2C PLib Transfer Read Add function */
    .read = (DRV_I2C_PLIB_READ)I2C1_Read,

    /* I2C PLib Transfer Write Add function */
    .write = (DRV_I2C_PLIB_WRITE)I2C1_Write,


    /* I2C PLib Transfer Write Read Add function */
    .writeRead = (DRV_I2C_PLIB_WRITE_READ)I2C1_WriteRead,

    /*I2C PLib Transfer Abort function */
    .transferAbort = (DRV_I2C_PLIB_TRANSFER_ABORT)I2C1_TransferAbort,

    /* I2C PLib Transfer Status function */
    .errorGet = (DRV_I2C_PLIB_ERROR_GET)I2C1_ErrorGet,

    /* I2C PLib Transfer Setup function */
    .transferSetup = (DRV_I2C_PLIB_TRANSFER_SETUP)I2C1_TransferSetup,

    /* I2C PLib Callback Register */
    .callbackRegister = (DRV_I2C_PLIB_CALLBACK_REGISTER)I2C1_CallbackRegister,
};


const DRV_I2C_INTERRUPT_SOURCES drvI2C0InterruptSources =
{
    /* Peripheral has more than one interrupt vector */
    .isSingleIntSrc                        = false,

    /* Peripheral interrupt lines */
    .intSources.multi.i2cInt0          = _I2C1_BUS_VECTOR,
    .intSources.multi.i2cInt1          = _I2C1_MASTER_VECTOR,
    .intSources.multi.i2cInt2          = -1,
    .intSources.multi.i2cInt3          = -1,
};

/* I2C Driver Initialization Data */
const DRV_I2C_INIT drvI2C0InitData =
{
    /* I2C PLib API */
    .i2cPlib = &drvI2C0PLibAPI,

    /* I2C Number of clients */
    .numClients = DRV_I2C_CLIENTS_NUMBER_IDX0,

    /* I2C Client Objects Pool */
    .clientObjPool = (uintptr_t)&drvI2C0ClientObjPool[0],

    /* I2C TWI Queue Size */
    .transferObjPoolSize = DRV_I2C_QUEUE_SIZE_IDX0,

    /* I2C Transfer Objects */
    .transferObjPool = (uintptr_t)&drvI2C0TransferObj[0],

    /* I2C interrupt sources */
    .interruptSources = &drvI2C0InterruptSources,

    /* I2C Clock Speed */
    .clockSpeed = DRV_I2C_CLOCK_SPEED_IDX0,
};

// </editor-fold>

// <editor-fold defaultstate="collapsed" desc="DRV_I2C Instance 1 Initialization Data">

/* I2C Client Objects Pool */
static DRV_I2C_CLIENT_OBJ drvI2C1ClientObjPool[DRV_I2C_CLIENTS_NUMBER_IDX1];

/* I2C Transfer Objects Pool */
static DRV_I2C_TRANSFER_OBJ drvI2C1TransferObj[DRV_I2C_QUEUE_SIZE_IDX1];

/* I2C PLib Interface Initialization */
const DRV_I2C_PLIB_INTERFACE drvI2C1PLibAPI = {

    /* I2C PLib Transfer Read Add function */
    .read = (DRV_I2C_PLIB_READ)I2C3_Read,

    /* I2C PLib Transfer Write Add function */
    .write = (DRV_I2C_PLIB_WRITE)I2C3_Write,


    /* I2C PLib Transfer Write Read Add function */
    .writeRead = (DRV_I2C_PLIB_WRITE_READ)I2C3_WriteRead,

    /*I2C PLib Transfer Abort function */
    .transferAbort = (DRV_I2C_PLIB_TRANSFER_ABORT)I2C3_TransferAbort,

    /* I2C PLib Transfer Status function */
    .errorGet = (DRV_I2C_PLIB_ERROR_GET)I2C3_ErrorGet,

    /* I2C PLib Transfer Setup function */
    .transferSetup = (DRV_I2C_PLIB_TRANSFER_SETUP)I2C3_TransferSetup,

    /* I2C PLib Callback Register */
    .callbackRegister = (DRV_I2C_PLIB_CALLBACK_REGISTER)I2C3_CallbackRegister,
};


const DRV_I2C_INTERRUPT_SOURCES drvI2C1InterruptSources =
{
    /* Peripheral has more than one interrupt vector */
    .isSingleIntSrc                        = false,

    /* Peripheral interrupt lines */
    .intSources.multi.i2cInt0          = _I2C3_BUS_VECTOR,
    .intSources.multi.i2cInt1          = _I2C3_MASTER_VECTOR,
    .intSources.multi.i2cInt2          = -1,
    .intSources.multi.i2cInt3          = -1,
};

/* I2C Driver Initialization Data */
const DRV_I2C_INIT drvI2C1InitData =
{
    /* I2C PLib API */
    .i2cPlib = &drvI2C1PLibAPI,

    /* I2C Number of clients */
    .numClients = DRV_I2C_CLIENTS_NUMBER_IDX1,

    /* I2C Client Objects Pool */
    .clientObjPool = (uintptr_t)&drvI2C1ClientObjPool[0],

    /* I2C TWI Queue Size */
    .transferObjPoolSize = DRV_I2C_QUEUE_SIZE_IDX1,

    /* I2C Transfer Objects */
    .transferObjPool = (uintptr_t)&drvI2C1TransferObj[0],

    /* I2C interrupt sources */
    .interruptSources = &drvI2C1InterruptSources,

    /* I2C Clock Speed */
    .clockSpeed = DRV_I2C_CLOCK_SPEED_IDX1,
};

// </editor-fold>

// <editor-fold defaultstate="collapsed" desc="DRV_SPI Instance 0 Initialization Data">

/* SPI Client Objects Pool */
static DRV_SPI_CLIENT_OBJ drvSPI0ClientObjPool[DRV_SPI_CLIENTS_NUMBER_IDX0];

/* SPI Transfer Objects Pool */
static DRV_SPI_TRANSFER_OBJ drvSPI0TransferObjPool[DRV_SPI_QUEUE_SIZE_IDX0];

/* SPI PLIB Interface Initialization */
const DRV_SPI_PLIB_INTERFACE drvSPI0PlibAPI = {

    /* SPI PLIB Setup */
    .setup = (DRV_SPI_PLIB_SETUP)SPI3_TransferSetup,

    /* SPI PLIB WriteRead function */
    .writeRead = (DRV_SPI_PLIB_WRITE_READ)SPI3_WriteRead,

    /* SPI PLIB Transfer Status function */
    .isTransmitterBusy = (DRV_SPI_PLIB_TRANSMITTER_IS_BUSY)SPI3_IsTransmitterBusy,

    /* SPI PLIB Callback Register */
    .callbackRegister = (DRV_SPI_PLIB_CALLBACK_REGISTER)SPI3_CallbackRegister,
};

const uint32_t drvSPI0remapDataBits[]= { 0x00000000, 0xFFFFFFFF, 0xFFFFFFFF, 0xFFFFFFFF, 0xFFFFFFFF, 0xFFFFFFFF, 0xFFFFFFFF, 0xFFFFFFFF, 0x00000400, 0x00000800 };
const uint32_t drvSPI0remapClockPolarity[] = { 0x00000000, 0x00000040 };
const uint32_t drvSPI0remapClockPhase[] = { 0x00000000, 0x00000100 };

const DRV_SPI_INTERRUPT_SOURCES drvSPI0InterruptSources =
{
    /* Peripheral has more than one interrupt vectors */
    .isSingleIntSrc                        = false,

    /* Peripheral interrupt lines */
    .intSources.multi.spiTxReadyInt      = -1,
    .intSources.multi.spiTxCompleteInt   = _SPI3_TX_VECTOR,
    .intSources.multi.spiRxInt           = _SPI3_RX_VECTOR,
};

/* SPI Driver Initialization Data */
const DRV_SPI_INIT drvSPI0InitData =
{
    /* SPI PLIB API */
    .spiPlib = &drvSPI0PlibAPI,

    .remapDataBits = drvSPI0remapDataBits,

    .remapClockPolarity = drvSPI0remapClockPolarity,

    .remapClockPhase = drvSPI0remapClockPhase,

    /* SPI Number of clients */
    .numClients = DRV_SPI_CLIENTS_NUMBER_IDX0,

    /* SPI Client Objects Pool */
    .clientObjPool = (uintptr_t)&drvSPI0ClientObjPool[0],


    /* SPI Queue Size */
    .transferObjPoolSize = DRV_SPI_QUEUE_SIZE_IDX0,

    /* SPI Transfer Objects Pool */
    .transferObjPool = (uintptr_t)&drvSPI0TransferObjPool[0],

    /* SPI interrupt sources (SPI peripheral and DMA) */
    .interruptSources = &drvSPI0InterruptSources,
};

// </editor-fold>


// *****************************************************************************
// *****************************************************************************
// Section: System Data
// *****************************************************************************
// *****************************************************************************
/* Structure to hold the object handles for the modules in the system. */
SYSTEM_OBJECTS sysObj;

// *****************************************************************************
// *****************************************************************************
// Section: Library/Stack Initialization Data
// *****************************************************************************
// *****************************************************************************


// *****************************************************************************
// *****************************************************************************
// Section: System Initialization
// *****************************************************************************
// *****************************************************************************

const SYS_DEBUG_INIT debugInit =
{
    .moduleInit = {0},
    .errorLevel = SYS_DEBUG_GLOBAL_ERROR_LEVEL,
    .consoleIndex = 0,
};


// <editor-fold defaultstate="collapsed" desc="SYS_TIME Initialization Data">

const SYS_TIME_PLIB_INTERFACE sysTimePlibAPI = {
    .timerCallbackSet = (SYS_TIME_PLIB_CALLBACK_REGISTER)CORETIMER_CallbackSet,
    .timerStart = (SYS_TIME_PLIB_START)CORETIMER_Start,
    .timerStop = (SYS_TIME_PLIB_STOP)CORETIMER_Stop ,
    .timerFrequencyGet = (SYS_TIME_PLIB_FREQUENCY_GET)CORETIMER_FrequencyGet,
    .timerPeriodSet = (SYS_TIME_PLIB_PERIOD_SET)NULL,
    .timerCompareSet = (SYS_TIME_PLIB_COMPARE_SET)CORETIMER_CompareSet,
    .timerCounterGet = (SYS_TIME_PLIB_COUNTER_GET)CORETIMER_CounterGet,
};

const SYS_TIME_INIT sysTimeInitData =
{
    .timePlib = &sysTimePlibAPI,
    .hwTimerIntNum = 0,
};

// </editor-fold>
// <editor-fold defaultstate="collapsed" desc="SYS_CONSOLE Instance 0 Initialization Data">


/* Declared in console device implementation (sys_console_uart.c) */
extern const SYS_CONSOLE_DEV_DESC sysConsoleUARTDevDesc;

const SYS_CONSOLE_UART_PLIB_INTERFACE sysConsole0UARTPlibAPI =
{
    .read = (SYS_CONSOLE_UART_PLIB_READ)UART1_Read,
	.readCountGet = (SYS_CONSOLE_UART_PLIB_READ_COUNT_GET)UART1_ReadCountGet,
	.readFreeBufferCountGet = (SYS_CONSOLE_UART_PLIB_READ_FREE_BUFFFER_COUNT_GET)UART1_ReadFreeBufferCountGet,
    .write = (SYS_CONSOLE_UART_PLIB_WRITE)UART1_Write,
	.writeCountGet = (SYS_CONSOLE_UART_PLIB_WRITE_COUNT_GET)UART1_WriteCountGet,
	.writeFreeBufferCountGet = (SYS_CONSOLE_UART_PLIB_WRITE_FREE_BUFFER_COUNT_GET)UART1_WriteFreeBufferCountGet,
};

const SYS_CONSOLE_UART_INIT_DATA sysConsole0UARTInitData =
{
    .uartPLIB = &sysConsole0UARTPlibAPI,    
};

const SYS_CONSOLE_INIT sysConsole0Init =
{
    .deviceInitData = (const void*)&sysConsole0UARTInitData,
    .consDevDesc = &sysConsoleUARTDevDesc,
    .deviceIndex = 0,
};



// </editor-fold>




// *****************************************************************************
// *****************************************************************************
// Section: Local initialization functions
// *****************************************************************************
// *****************************************************************************



/*******************************************************************************
  Function:
    void SYS_Initialize ( void *data )

  Summary:
    Initializes the board, services, drivers, application and other modules.

  Remarks:
 */

void SYS_Initialize ( void* data )
{
    /* MISRAC 2012 deviation block start */
    /* MISRA C-2012 Rule 2.2 deviated in this file.  Deviation record ID -  H3_MISRAC_2012_R_2_2_DR_1 */

    /* Start out with interrupts disabled before configuring any modules */
    __builtin_disable_interrupts();

  
    CLK_Initialize();
    /* Configure Prefetch, Wait States and ECC */
    PRECONbits.PREFEN = 3;
    PRECONbits.PFMWS = 3;
    CFGCONbits.ECCCON = 3;



	GPIO_Initialize();

	SPI3_Initialize();

	CMP_Initialize();

    CORETIMER_Initialize();
    I2C1_Initialize();

    I2C3_Initialize();

	UART1_Initialize();


    /* Initialize I2C0 Driver Instance */
    sysObj.drvI2C0 = DRV_I2C_Initialize(DRV_I2C_INDEX_0, (SYS_MODULE_INIT *)&drvI2C0InitData);
    /* Initialize I2C1 Driver Instance */
    sysObj.drvI2C1 = DRV_I2C_Initialize(DRV_I2C_INDEX_1, (SYS_MODULE_INIT *)&drvI2C1InitData);
    /* Initialize SPI0 Driver Instance */
    sysObj.drvSPI0 = DRV_SPI_Initialize(DRV_SPI_INDEX_0, (SYS_MODULE_INIT *)&drvSPI0InitData);

    sysObj.sysDebug = SYS_DEBUG_Initialize(SYS_DEBUG_INDEX_0, (SYS_MODULE_INIT*)&debugInit);


    sysObj.sysTime = SYS_TIME_Initialize(SYS_TIME_INDEX_0, (SYS_MODULE_INIT *)&sysTimeInitData);
    sysObj.sysConsole0 = SYS_CONSOLE_Initialize(SYS_CONSOLE_INDEX_0, (SYS_MODULE_INIT *)&sysConsole0Init);



    APP_Initialize();


    EVIC_Initialize();

	/* Enable global interrupts */
    __builtin_enable_interrupts();


    /* MISRAC 2012 deviation block end */
}


/*******************************************************************************
 End of File
*/
