BlockWorker/USBPD-Supply/firmware/src/config/default/peripheral/evic/plib_evic.c

/*******************************************************************************
  EVIC PLIB Implementation

  Company:
    Microchip Technology Inc.

  File Name:
    plib_evic.c

  Summary:
    EVIC PLIB Source File

  Description:
    None

*******************************************************************************/

// DOM-IGNORE-BEGIN
/*******************************************************************************
* Copyright (C) 2019 Microchip Technology Inc. and its subsidiaries.
*
* Subject to your compliance with these terms, you may use Microchip software
* and any derivatives exclusively with Microchip products. It is your
* responsibility to comply with third party license terms applicable to your
* use of third party software (including open source software) that may
* accompany Microchip software.
*
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
* IN NO EVENT WILL MICROCHIP BE LIABLE FOR ANY INDIRECT, SPECIAL, PUNITIVE,
* INCIDENTAL OR CONSEQUENTIAL LOSS, DAMAGE, COST OR EXPENSE OF ANY KIND
* WHATSOEVER RELATED TO THE SOFTWARE, HOWEVER CAUSED, EVEN IF MICROCHIP HAS
* BEEN ADVISED OF THE POSSIBILITY OR THE DAMAGES ARE FORESEEABLE. TO THE
* FULLEST EXTENT ALLOWED BY LAW, MICROCHIP'S TOTAL LIABILITY ON ALL CLAIMS IN
* ANY WAY RELATED TO THIS SOFTWARE WILL NOT EXCEED THE AMOUNT OF FEES, IF ANY,
* THAT YOU HAVE PAID DIRECTLY TO MICROCHIP FOR THIS SOFTWARE.
*******************************************************************************/
// DOM-IGNORE-END

#include "device.h"
#include "plib_evic.h"


EXT_INT_PIN_CALLBACK_OBJ extInt1CbObj;
EXT_INT_PIN_CALLBACK_OBJ extInt4CbObj;
// *****************************************************************************
// *****************************************************************************
// Section: IRQ Implementation
// *****************************************************************************
// *****************************************************************************

void EVIC_Initialize( void )
{
    INTCONSET = _INTCON_MVEC_MASK;

    /* Set up priority and subpriority of enabled interrupts */
    IPC0SET = 0x8 | 0x0;  /* CORE_TIMER:  Priority 2 / Subpriority 0 */
    IPC2SET = 0x10 | 0x0;  /* EXTERNAL_1:  Priority 4 / Subpriority 0 */
    IPC5SET = 0x10000000 | 0x0;  /* EXTERNAL_4:  Priority 4 / Subpriority 0 */
    IPC28SET = 0x4 | 0x0;  /* UART1_FAULT:  Priority 1 / Subpriority 0 */
    IPC28SET = 0x400 | 0x0;  /* UART1_RX:  Priority 1 / Subpriority 0 */
    IPC28SET = 0x40000 | 0x0;  /* UART1_TX:  Priority 1 / Subpriority 0 */
    IPC28SET = 0x4000000 | 0x0;  /* I2C1_BUS:  Priority 1 / Subpriority 0 */
    IPC29SET = 0x1000 | 0x0;  /* I2C1_MASTER:  Priority 4 / Subpriority 0 */
    IPC32SET = 0x40000 | 0x0;  /* COMPARATOR_1:  Priority 1 / Subpriority 0 */
    IPC38SET = 0x4000000 | 0x0;  /* SPI3_RX:  Priority 1 / Subpriority 0 */
    IPC39SET = 0x4 | 0x0;  /* SPI3_TX:  Priority 1 / Subpriority 0 */
    IPC40SET = 0x4 | 0x0;  /* I2C3_BUS:  Priority 1 / Subpriority 0 */
    IPC40SET = 0x100000 | 0x0;  /* I2C3_MASTER:  Priority 4 / Subpriority 0 */

    /* Initialize External interrupt 1 callback object */
    extInt1CbObj.callback = NULL;
    /* Initialize External interrupt 4 callback object */
    extInt4CbObj.callback = NULL;


    /* Configure Shadow Register Set */
    PRISS = 0x76543210;

    while (PRISS != 0x76543210)
    {
        /* Wait for PRISS value to take effect */
    }
}

void EVIC_SourceEnable( INT_SOURCE source )
{
    volatile uint32_t *IECx = (volatile uint32_t *) (&IEC0 + ((0x10 * (source / 32)) / 4));
    volatile uint32_t *IECxSET = (volatile uint32_t *)(IECx + 2);

    *IECxSET = 1 << (source & 0x1f);
}

void EVIC_SourceDisable( INT_SOURCE source )
{
    volatile uint32_t *IECx = (volatile uint32_t *) (&IEC0 + ((0x10 * (source / 32)) / 4));
    volatile uint32_t *IECxCLR = (volatile uint32_t *)(IECx + 1);

    *IECxCLR = 1 << (source & 0x1f);
}

bool EVIC_SourceIsEnabled( INT_SOURCE source )
{
    volatile uint32_t *IECx = (volatile uint32_t *) (&IEC0 + ((0x10 * (source / 32)) / 4));

    return (bool)((*IECx >> (source & 0x1f)) & 0x01);
}

bool EVIC_SourceStatusGet( INT_SOURCE source )
{
    volatile uint32_t *IFSx = (volatile uint32_t *)(&IFS0 + ((0x10 * (source / 32)) / 4));

    return (bool)((*IFSx >> (source & 0x1f)) & 0x1);
}

void EVIC_SourceStatusSet( INT_SOURCE source )
{
    volatile uint32_t *IFSx = (volatile uint32_t *) (&IFS0 + ((0x10 * (source / 32)) / 4));
    volatile uint32_t *IFSxSET = (volatile uint32_t *)(IFSx + 2);

    *IFSxSET = 1 << (source & 0x1f);
}

void EVIC_SourceStatusClear( INT_SOURCE source )
{
    volatile uint32_t *IFSx = (volatile uint32_t *) (&IFS0 + ((0x10 * (source / 32)) / 4));
    volatile uint32_t *IFSxCLR = (volatile uint32_t *)(IFSx + 1);

    *IFSxCLR = 1 << (source & 0x1f);
}

void EVIC_INT_Enable( void )
{
    __builtin_enable_interrupts();
}

bool EVIC_INT_Disable( void )
{
    uint32_t processorStatus;

    /* Save the processor status and then Disable the global interrupt */
    processorStatus = ( uint32_t )__builtin_disable_interrupts();

    /* return the interrupt status */
    return (bool)(processorStatus & 0x01);
}

void EVIC_INT_Restore( bool state )
{
    if (state)
    {
        /* restore the state of CP0 Status register before the disable occurred */
        __builtin_enable_interrupts();
    }
}

void EVIC_ExternalInterruptEnable( EXTERNAL_INT_PIN extIntPin )
{
    IEC0SET = extIntPin;
}

void EVIC_ExternalInterruptDisable( EXTERNAL_INT_PIN extIntPin )
{
    IEC0CLR = extIntPin;
}

bool EVIC_ExternalInterruptCallbackRegister(
    EXTERNAL_INT_PIN extIntPin,
    const EXTERNAL_INT_PIN_CALLBACK callback,
    uintptr_t context
)
{
    bool status = true;
    switch  (extIntPin)
        {
        case EXTERNAL_INT_1:
            extInt1CbObj.callback = callback;
            extInt1CbObj.context  = context;
            break;
        case EXTERNAL_INT_4:
            extInt4CbObj.callback = callback;
            extInt4CbObj.context  = context;
            break;
        default:
            status = false;
            break;
        }

    return status;
}


// *****************************************************************************
/* Function:
    void EXTERNAL_1_InterruptHandler(void)

  Summary:
    Interrupt Handler for External Interrupt pin 1.

  Remarks:
	It is an internal function called from ISR, user should not call it directly.
*/
void EXTERNAL_1_InterruptHandler(void)
{
    IFS0CLR = _IFS0_INT1IF_MASK;

    if(extInt1CbObj.callback != NULL)
    {
        extInt1CbObj.callback (EXTERNAL_INT_1, extInt1CbObj.context);
    }
}


// *****************************************************************************
/* Function:
    void EXTERNAL_4_InterruptHandler(void)

  Summary:
    Interrupt Handler for External Interrupt pin 4.

  Remarks:
	It is an internal function called from ISR, user should not call it directly.
*/
void EXTERNAL_4_InterruptHandler(void)
{
    IFS0CLR = _IFS0_INT4IF_MASK;

    if(extInt4CbObj.callback != NULL)
    {
        extInt4CbObj.callback (EXTERNAL_INT_4, extInt4CbObj.context);
    }
}


/* End of file */
