BlockWorker/USBPD-Supply/(commit log)

2023-04-05 Initial commit, basic design up to first USB port
    [UCC25640x Design Calculator Rev4.0.xlsx, UCC28056X_Design Calculator.xls, main.brd, main.sch]
2023-04-08 Added firmware base, layout in progress
    [UCC25640x Design Calculator Rev4.0.xlsx, configuration.h, main.brd]
2023-04-12 Supply PCB done (?)
    [UCC25640x Design Calculator Rev4.0.xlsx, UCC28056X_Design Calculator.xls, main.brd, main.sch]
2023-05-07 Base design complete, adapter firmware started
    [adapter.brd, adapter.sch, back.dxf, front.dxf, main.brd, main.sch, solderpractice.brd, solderpractice.sch]
