BlockWorker/USBPD-Supply/(notices)

Notices in the files:
main.brd:
©2023 BlockWorker
parts and their libraries:
Eagle_WE-CMB: Copyright: Würth Elektronik
COPYRIGHT: Copyright (C) 2023 Ultra Librarian. All rights reserved.
